martan3d/AirMiniTransmitter/pcb/BlueRidgeEngineering/completed.png

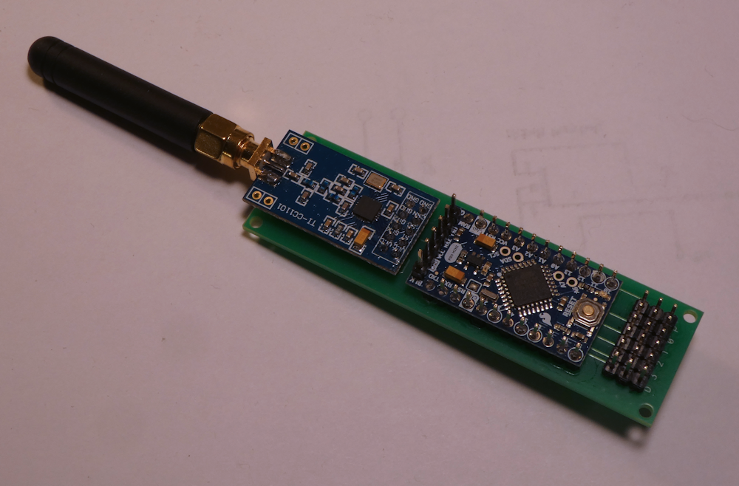
pcb/BlueRidgeEngineering/completed.png
