martan3d/AirMiniTransmitter/doc/Including_Timer_Latency_Effects.pdf

## Including Latency Effects in Arduino ISR’s

See file ArduinoInterrupts.pdf (and probably here). (https://my.eng.utah.edu/~cs5789/handouts/ArduinoInterrupts.pdf)

This shows how the to-be-determined CNT(?) is determined.

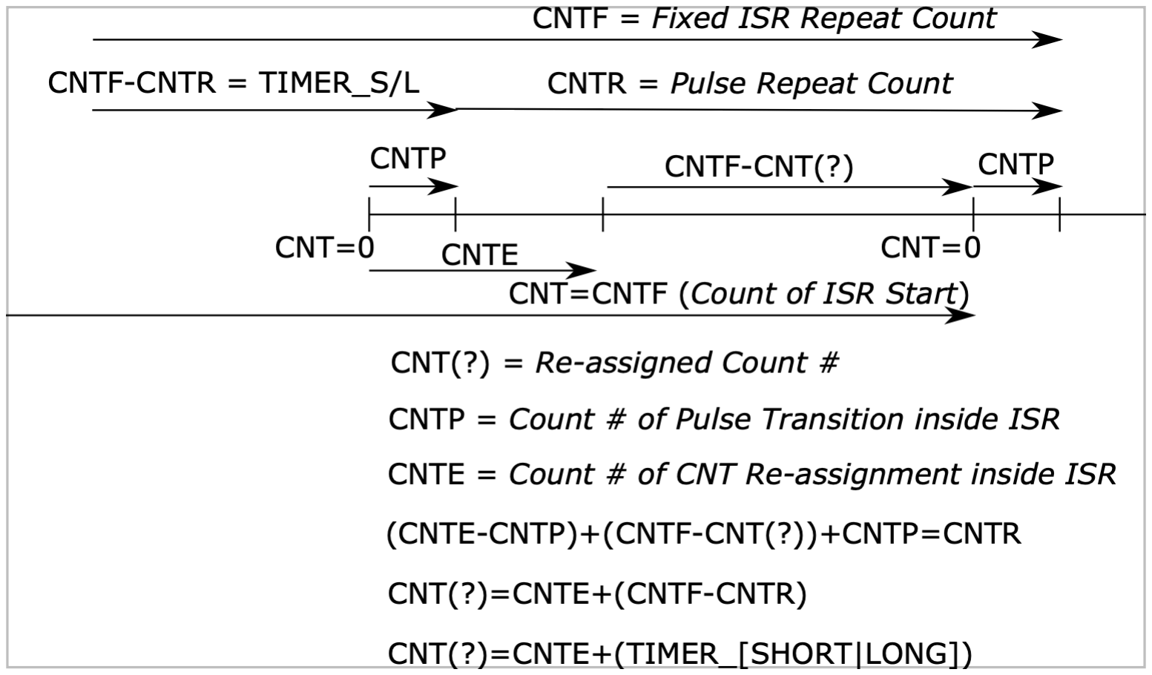
[picture p8: figure]

See https://www.avrfreaks.net/forum/tut-c-newbiesguide-avr-timers?
name=PNphpBB2&file=viewtopic&t=50106 (https://www.avrfreaks.net/forum/tut-c-newbies-guide-avr-timers?name=PNphpBB2&file=viewtopic&t=50106) for a decent interrupt tutorial
