martan3d/AirMiniTransmitter/pcb/BlueRidgeEngineering/bottomlayer.png

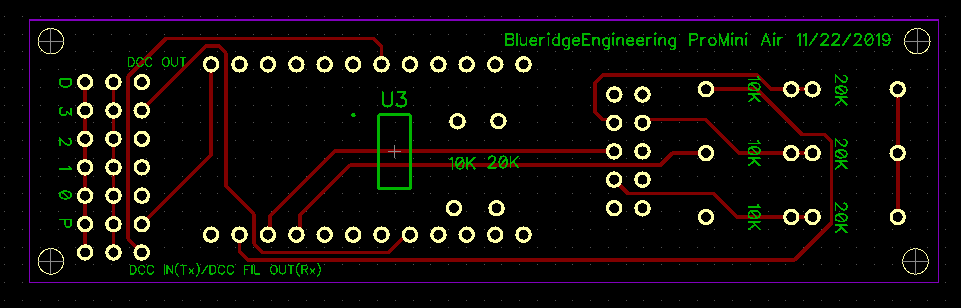
pcb/BlueRidgeEngineering/bottomlayer.png
