martan3d/AirMiniTransmitter/pcb/BlueRidgeEngineering/toplayer.png

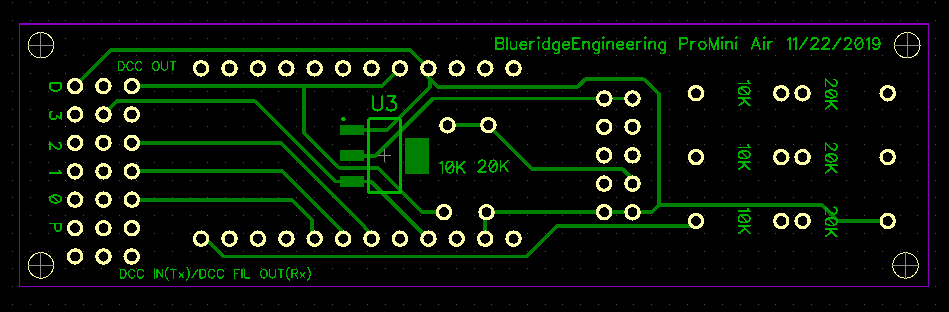
pcb/BlueRidgeEngineering/toplayer.png
