martan3d/AirMiniTransmitter/doc/ProMiniAir_Users_Manual.pdf

## User’s Manual for the ProMiniAir Transmitter and Receiver

OScaleDeadRail
https://oscaledeadrail.com

Darrell Lamm
darrelllamm0@gmail.com

January 29, 2025
Copyright© 2019-2024, Darrell Lamm. All rights reserved.

## Contents

1 Introduction | 4
2 About DCC | 4
3 Quick-Start | 4
3.1 Using Multiple Transmitters with Multiple PMA Receivers on Different
4 ProMiniAir Settings/Configuration | 15
5 Integration | 18
6 RF Receiver Compatibility | 24
A Firmware Installation | 41
B Regulatory Notices | 44
References | 46
Abbreviations/Acronyms | 46
Glossary | 46

## List of Figures

1 | Typical model railroad battery-powered radio-controlled application . . . . | 5
2 | The ProMiniAir transmitter using an external DCC throttle | | 6
3 | The components and connections needed for the ProMiniAir transmitter
| using an external DCC throttle | | 7
4 | Integrated ProMiniAir/WiFi-equipped EX-CommandStation transmitter . . | 7
5 | The components and connections needed for the “stand-alone” ProMiniAir
| transmitter | | 8
6 | Example of ProMiniAir receiver connections (w DRV8871) | | 9
7 | The components and connections needed for the ProMiniAir receiver (DRV8871
amplifier) | 10
8 | Example ProMiniAir receiver connections (w Cytron MD13S) | 11
9 | The components and connections needed for the ProMiniAir receiver (Cytron
amplifier) | 12
10 | LCD showing DCC message sent | 12
11 | LCD showing DCC message received | 13
12 | Receiver LCD display | 14
13 | The ProMiniAir antenna connector (U.FL) | 19
14 | ProMiniAir connections for AVR programmer | 19
15 | ProMiniAir receiver connections | 21
16 | ProMiniAir transmitter connections | 23
17 | ProMiniAir receiver integration with battery power, a Cytron H-bridge
“amp,” and antenna | 24
18 ProMiniAir receiver integration with battery power, a DRV8871 H-bridge
“amp,” and antenna | 25
19 | DCC data collected from a “typical” and Airwire throttle | 27
20 | Gwire U.FL connector | 28
21 | Tam Valley Depot DRS1, MKIII | 29
22 | The recently-released Tam Valley Depot DRS1, MkIV receiver | 29
23 | The recently-released Tam Valley Depot DRS1, MkIV receiver with U.FL
plug | 30
24 | The NCE D13DRJ wireless decoder | 31
25 | The S-Cab LXR-DCC receiver with a built-in antenna | 33
26 | Demonstration that the ProMiniAir transmitter successfully transmits to the
LXR-DCC receiver | 34
27 | ProMiniAir’s outputs with valid RF DCC signal | 38
28 | ProMiniAir’s insertion of last DCC packet when no valid RF DCC signal,
filtering off | 39
29 | Tam Valley Depot and Gwire outputs with no valid RF DCC signal | 39
30 | ProMiniAir’s outputs with no valid RF DCC signal, filtering on | 40
31 | GitHub Source download | 41

## List of Tables

1 | ProMiniAir Settings and Configuration | 17
2 | RF Receiver Summary | 26

## 1 Introduction

NOTE: Continuous hardware and software improvements will always outpace documentation updates.
Before understanding how to set up and use the ProMiniAir transmitter and receiver, let’s set the stage with Figure 1. What’s different from typical model railroads is that power comes from a battery rather than electrified rails, and DCC (more about this in a moment) control information is received by a radio receiver (from a radio transmitter connected to a DCC throttle) rather than from DCC signals imposed on the track voltage by a throttle. This battery-powered, radio-controlled method of operation is sometimes called “dead-rail” because neither power nor signal is applied to the rails.

## 2 About DCC

We’ll introduce some terminology that may be new. The National Model Railroad Association (NMRA) set forth a standard [1] for communicating with decoders onboard locomotives and other model railroad devices called Digital Command Control (DCC). DCC-compliant throttles control and configure these devices by sending coded, digital voltage waveforms over wires or tracks (usually) to these devices, which sift out those addressed to them. These coded waveforms contain digital messages or “packets” specify an action and an “Address” that determines the recipient device. Most DCC packets are addressed to a specific recipient, although a few kinds of messages are for all listening recipients.
Any DCC output (say from Digitrax, NCE, or other DCC throttle such as the lowcost WiFi-equipped EX-CommandStation (https://dcc-ex.com) we offer) can be wirelessly transmitted using the ProMiniAir transmitter over the “Airwire Channels” 0-16 in the North American 902– 928 MHz or European 868-870 MHz “ISM Band” band (the Airwire or European channel (channel 18) and output power level is adjustable as described below) to a variety of RF receivers, including the ProMiniAir receiver, that in turn, convert the RF transmissions back to DCC signals any DCC decoder can “understand.”
We also provide a North American channel 17 for Stanton-Cab transmitters (to the ProMiniAir receiver) or Stanton-Cab receivers (from the ProMiniAir transmitter).
After the ProMiniAir has been interfaced and powered as described in the next section, the ProMiniAir transmitter or receiver can be operated without further ado. However, you can reconfigure some aspects of the ProMiniAir’s operation as described later in this Manual.

## 3 Quick-Start

We provide the ProMiniAir transmitter or receiver as a fully-assembled, modular device, already connected to any additional modular components necessary to act as either a transmitter or receiver.

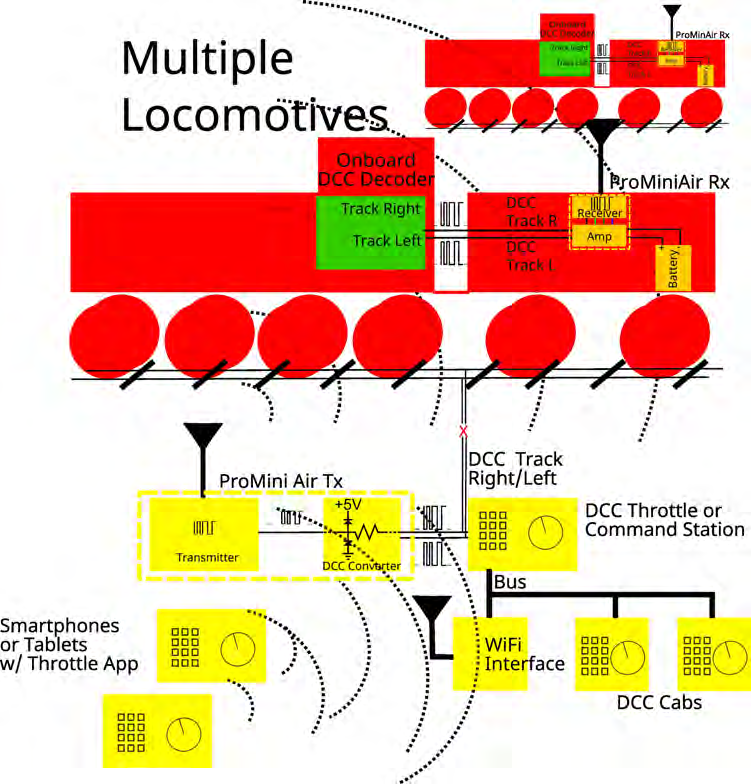
[picture p11: figure]

Figure 1: Typical model railroad battery-powered radio-controlled application. In some cases, such as the Airwire transmitters, the throttle and transmitter are combined. Also, the receiver and amplifier may be combined, such as for Airwire and Tam Valley Depot receivers. We provide the required DCC Converter for the ProMiniAir Tx or DCC Amplifier for the ProMiniAir Rx.

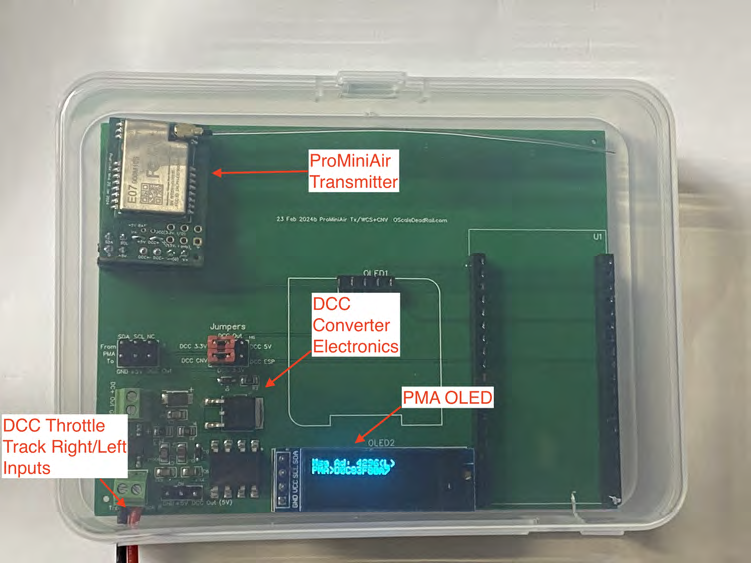
[picture p12: figure]

Figure 2: The ProMiniAir transmitter using an external DCC throttle. The components are now integrated on a PCB to eliminate wiring problems.

For the ProMiniAir transmitter, you simply connect the DCC Converter to a DCC throttle’s Track R/L output that is used as both a power and DCC data source (Figures 3 and 2), or simply plug in power to use the WiFi-equipped EX-CommandStation (https://dcc-ex.com) we offer as a fully standalone transmitter that allows you to use a smartphone’s WiThrottle-compatible app to connect to the ProMiniAir transmitter (Figures 4 and 5).
If you are using the integrated, “Standalone” PMA Tx/WiFi+EX-CommandStation, see these instructions. (https://oscaledeadrail.com/instructions-for-the-standalone-prominiair-transmitter/)
For the ProMiniAir receiver, connect battery power to the power harness plug and plug the DCC amplifier’s output to the Track R/L inputs to the DCC decoder (Figure 9 and 6). Both the ProMiniAir transmitter and receiver can be optionally connected to an Organic Light-Emitting Diode (OLED) display that uses the “I2C” interface that uses ProMiniAir outputs GND, VCC (+5V), SDA (3.3V data), and SCL (3.3V clock) as input. The display provides information on DCC messages received (PMA < DCC Packet) and sent (PMA > DCC Packet). See Figures 10 and 11. Note that some figures show an older Liquid Crystal Display (LCD) no longer used with ProMiniAir.

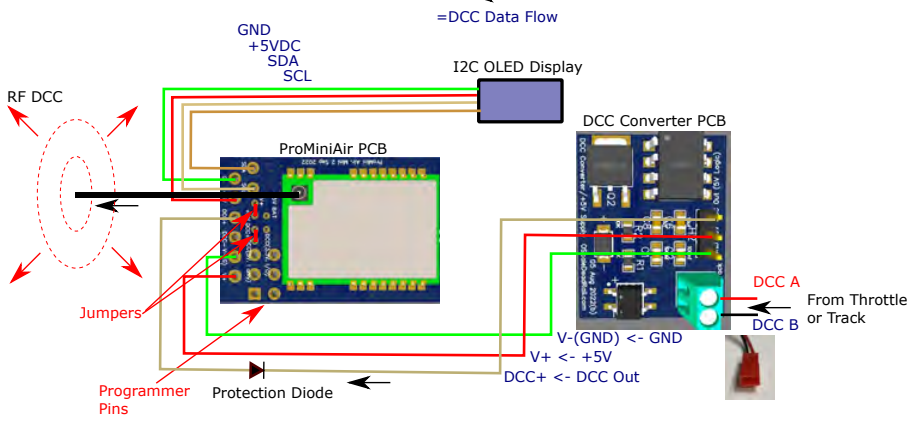
[picture p13: figure]
DCC B; DCC A; DCC Converter PCB; ProMiniAir PCB; From Throttle or Track; RF DCC; I2C OLED Display; =DCC Data Flow; DCC+ <- DCC Out; V-(GND) <- GND; GND +5VDC SDA SCL; Programmer; Protection Diode; Pins; Jumpers

Figure 3: The components and connections needed for the ProMiniAir transmitter using an external DCC throttle

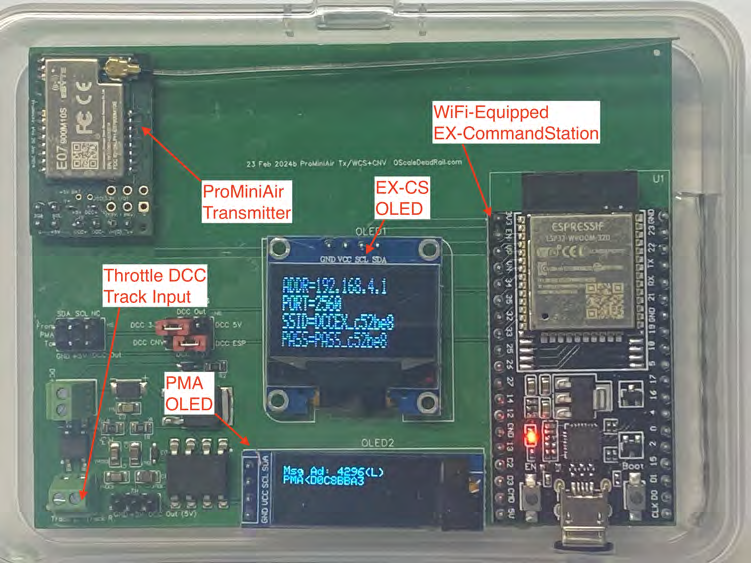
[picture p14: figure]

Figure 4: Integrated ProMiniAir/WiFi-equipped EX-CommandStation (https://dcc-ex.com) transmitter. The DCC converter is retained to provide optional external throttle DCC inputs to the EX-CommandStation. (https://dcc-ex.com) The ProMiniAir transmitter is then directly connected to the WiFi-equipped EX-CommandStation’s (https://dcc-ex.com) DCC outputs for a complete, stand-alone solution, allowing connections from both USB-connected and smartphone throttles, as well as allowing DCC inputs from an external throttle.

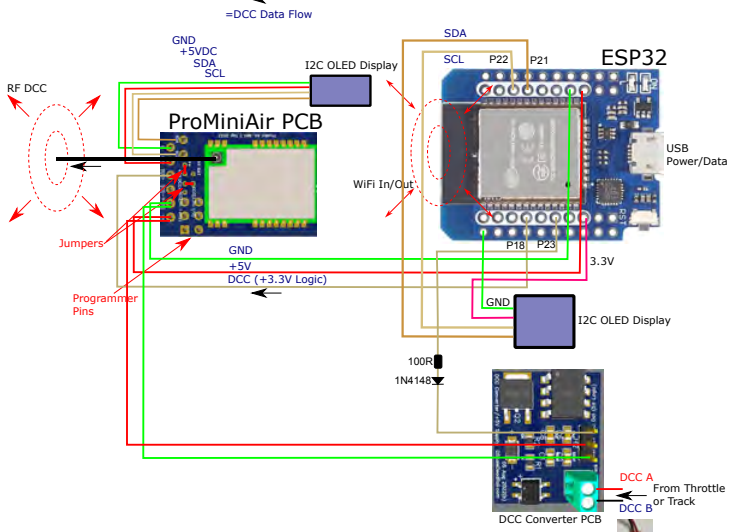
[picture p15: figure]
ESP32; ProMiniAir PCB; RF DCC; I2C OLED Display; =DCC Data Flow; DCC (+3.3V Logic); GND; GND +5VDC SDA SCL; WiFi In/Out; SDA; SCL; USB Power/Data; DCC B; DCC A From Throttle or Track; DCC Converter PCB; Programmer Pins; Jumpers

Figure 5: The components and connections needed for the “stand-alone” ProMiniAir transmitter with optional DCC throttle input.

Of course the OLED display cannot be used once the ProMiniAir receiver is mounted, but we strongly suggest that you keep the OLED display connected to the ProMiniAir transmitter so you can monitor the ProMiniAir transmitter’s state such as broadcast channel and power, and DCC message content.

### 3.1 Using Multiple Transmitters with Multiple PMA Receivers on Different Channels

Only on startup, the ProMiniAir Receiver will “listen” on its Default Channel, and if it doesn’t find a valid signal, it will start scanning on Channels in the following order: 0(A), 18(E), 17(S), 1(A), 2(A), 3(A), 4(A), 5(A), 6(A), 7(A), 8(A), 9(A), 10(A), 11(A), 12(A), 13(A), 14(A), 15(A), and 16(A); where A=Airwire, E=EU, and S=Stanton Cab. This feature allows an easy technique for using multiple compatible transmitters (ProMiniAirtransmitters, such as Airwire transmitters, etc.) that transmit on different Channels using the following technique:

1. Ensure all transmitters and receivers are OFF.
2. Turn ON Transmitter #1 on Channel C#1 (C#1 = 0, 1, ..., 18)
3. Turn ON only the ProMiniAir Receivers you want to auto-scan and “lock” on Channel C#1. It is useful to test the locos to ensure the onboard ProMiniAir Receiver has properly locked on Channel C#1.
4. Turn OFF Transmitter #1. Leave the receivers ON! The ProMiniAir Receivers will stay locked on Channel #1, patiently waiting for a valid signal on this Channel!

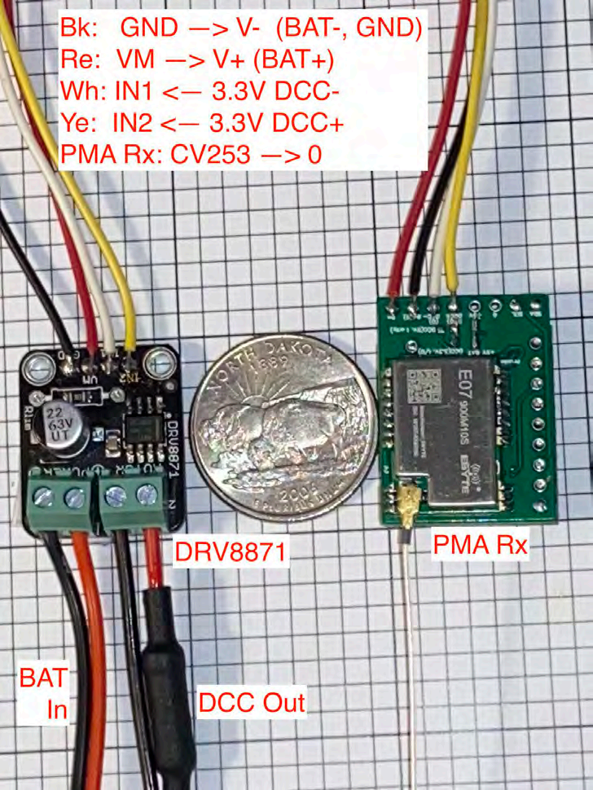
[picture p16: figure]

Figure 6: Example ProMiniAir receiver connections with a DRV8871 amplifier. Note the 1-ohm current-limiting resistor on the DCC out.

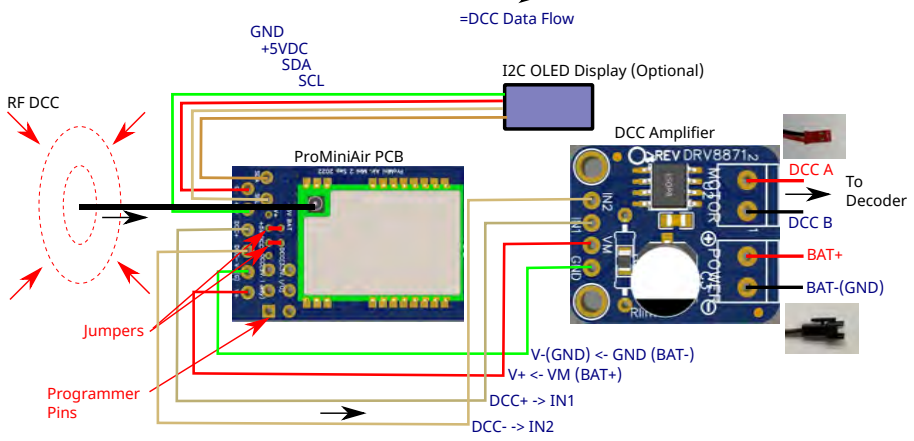
[picture p17: figure]
DCC B; DCC A; DCC Amplifier; ProMiniAir PCB; To Decoder; RF DCC; I2C OLED Display (Optional); =DCC Data Flow; DCC+ -> IN1; V+ <- VM (BAT+); V-(GND) <- GND (BAT-); GND +5VDC SDA SCL; DCC- -> IN2; BAT+; BAT-(GND); Programmer Pins; Jumpers

Figure 7: The components and connections needed for the ProMiniAir receiver for an H-bridge “amplifier” that uses opposite-polarity inputs.

5. Turn ON Transmitter #2 on Channel C#2 (please make sure C#2 is NOT the same as C#1).
6. Turn ON the next set of ProMiniAir Receivers that you want to auto-scan and “lock” on Channel C#2. Again, it’s useful to test the locos operating on this Channel.
7. Turn OFF Transmitter #2. At this point, no transmitters should be ON, but two groups of ProMiniAir Receivers locked locked on to Channel C#1 or C#2 remain ON.
8. Continue to Steps 5–7 for all additional Transmitters and groups ProMiniAir Receivers.
9. At this point in time all Transmitters should be OFF with all ProMiniAir Receives patiently waiting in groups locked onto Channels C#1, C#2, etc.
10. Now turn ON all of the Transmitters! Each group of ProMiniAir Receivers will now receive valid signals on the Channel it locked onto at startup!

In addition to the DCC message info provided in Figures 10 and 11, the ProMiniAir receiver’s OLED display also provides either the incoming DCC message’s address or the ProMiniAir own address, the channel number it’s receiving on, and the filtering status. See Figure 12.
Newer versions of the ProMiniAir use more compact and power-conserving OLED (128x32) displays. The information conveyed on OLEDs is the same as that on LCDs. Of course, once the ProMiniAir receiver is mounted, we cannot use the OLED (LCD) display. Still, we strongly suggest that you keep the OLED (LCD) display connected to the

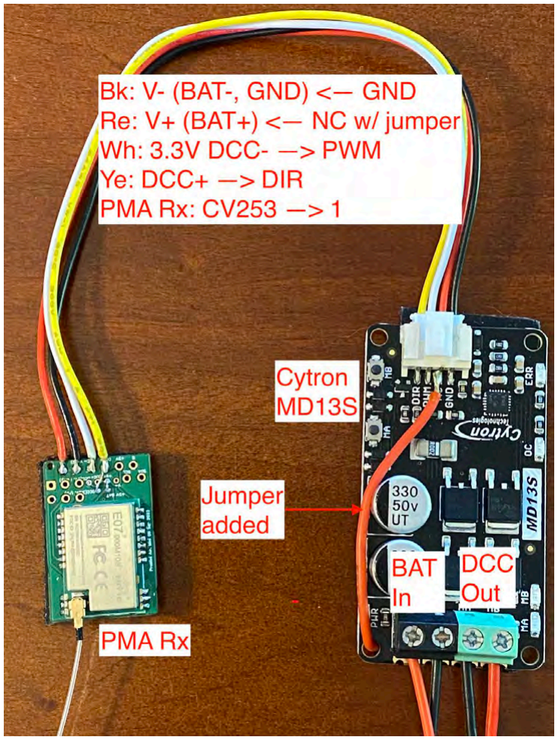
[picture p18: figure]

Figure 8: Example ProMiniAir receiver connections with a Cytron MD13S “amp”

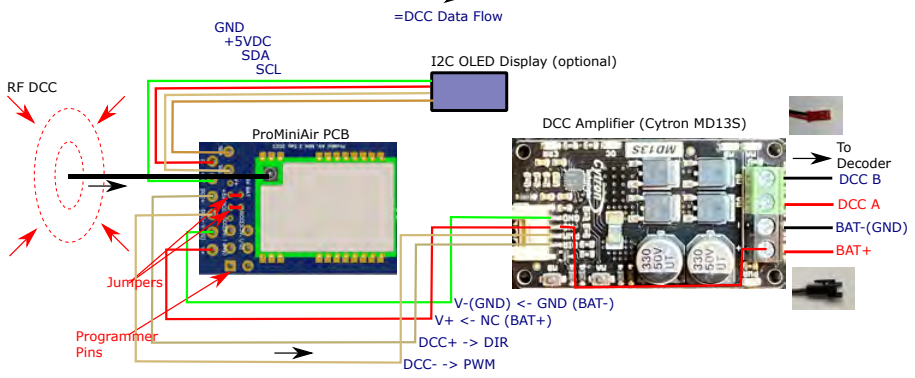
[picture p19: figure]
DCC B; DCC A; To Decoder; RF DCC; I2C OLED Display (optional); =DCC Data Flow; DCC+ -> DIR; V+ <- NC (BAT+); V-(GND) <- GND (BAT-); GND +5VDC SDA SCL; DCC- -> PWM; BAT+; BAT-(GND); Programmer Pins; Jumpers

DCC Amplifier (Cytron MD13S) ProMiniAir PCB

Figure 9: The components and connections needed for the ProMiniAir receiver (Cytron amplifier) that uses “locked anti-phase” inputs.

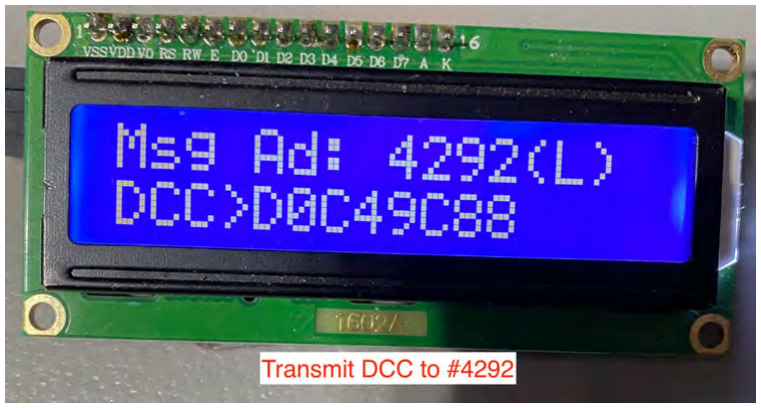
[picture p20: figure]

Figure 10: LCD showing message DCC sent (Tx: sent wirelessly; Rx: sent to DCC amplifier)

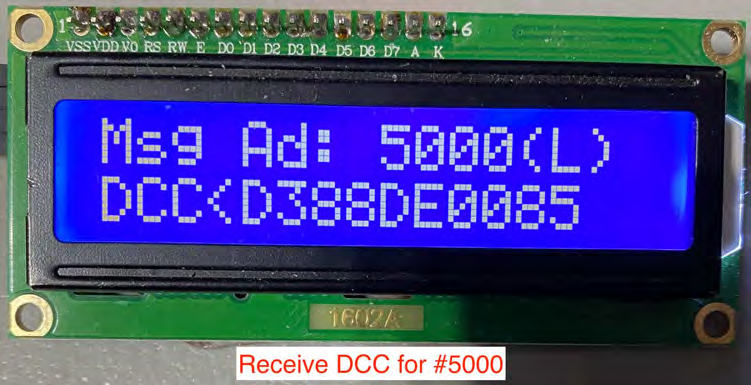
[picture p21: figure]

Figure 11: LCD showing message DCC received (Tx: received from DCC throttle; Rx: received wirelessly)

ProMiniAir transmitter so that you can monitor changes in the ProMiniAir transmitter’s settings, such as broadcast channel and power.

### 3.2 Additional Technical Information

The ProMiniAir requires interfacing with additional electronics that we provide. For the transmitter, the DCC signals that would normally be applied to the tracks by a DCC throttle are input to a simple “DCC Converter” that provides both 5V DC power and 5V logic DCC signal for the ProMiniAir transmitter. See Figure 3 and 2.
The “stand-alone” ProMiniAir transmitter does NOT require, but can use, an external DCC throttle and is its own DCC command station with WiFi and USB that allow external apps to run on a smartphone or PC to send throttle commands to the onboard DCC command station. See Figures 5 and 4 for the connections between the EPS32 hosting the command station software and the ProMiniAir transmitter.
Newer versions of the ProMiniAir transmitter use 3.3V logic DCC as input. In this case, a “protection” switching diode (1N4148), pointing “against” the input, is supplied that connects between the +5V DCC source and the 3.3V DCC input to the ProMiniAir transmitter. Technically, the ProMiniAir activates the internal “pull-up” resistor of the DCC+ input allows the diode to limit input voltages properly. Any ProMiniAir provided to you will have the proper interfacing between the DCC Converter and the ProMiniAir

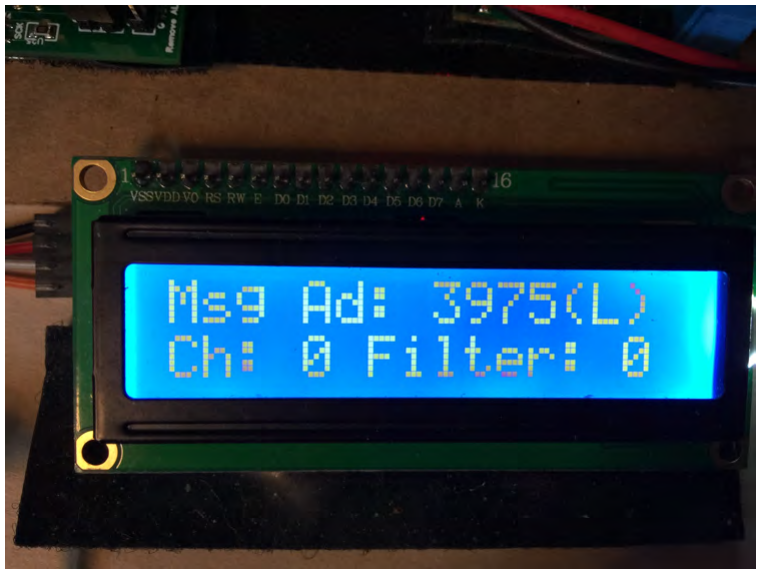
[picture p22: figure]

Figure 12: Receiver LCD showing message or self-address, channel number, and filtering status

receiver.
For the ProMiniAir receiver, the 5V (or 3.3V for newer versions) logic DCC signal outputs DCC+/DCC- from the ProMiniAir receiver is converted by a “DCC amplifier” back to “track DCC” signals that an onboard DCC decoder can “understand.” See Figures 9, 7 6, 8 for examples of connections of the ProMiniAir receiver with H-bridges that use either “locked anti-phase” inputs (DCC+ → 3.3V DCC, DCC- → +3.3V DC) or opposite polarity inputs (DCC+ → “positive 3.3V DCC”, DCC- → “opposite-polarity 3.3V DCC”).
We decided to take this modular approach to allow the following:
1. separation of the transceiver from other electronics that might cause RF interference,
2. the user to replace failed components (and not the entire assembly), and
3. us to reduce our exposure to supply chain disruptions and parts obsolescence, keeping costs low.

We believe this “modular” approach gives you installation and parts replacement flexibility. An additional benefit of the ProMiniAir’s modularity is that we can repurpose a transmitter as a receiver or vice versa with a simple firmware change.

### 3.3 Antennas for the ProMiniAir

The ProMiniAir transmitter comes with a “whip” antenna that preserves FCC/IC/ETSI/CE approval for the ProMiniAir transmitter containing the Anaren A110LR09x or A1101R09x, or the Ebyte E07-900M10S transceiver daughterboards. The approval numbers are the following:
- FCC ID: X7J-A1107 (Anaren), 2ALPH-E07900M10S (Ebyte)
- IC: 8975A-A11072401

The OScaleDeadRail site (https://oscaledeadrail.com/information-on-the-promini-air-receiver-and-transmitter/) discusses antennas that may be used with the ProMiniAir receiver in cases where the provided whip antenna is not feasible to use. We do not recommend you replace the approved antenna for the ProMiniAir transmitter because it may violate the FCC/IC/ETSI/CE approvals for an “active transmitter.”

## 4 ProMiniAir Settings/Configuration

Note: The instructions here refer to both the ProMiniAir transmitter (Tx) and receiver (Rx). Where necessary, we will try to differentiate between these options with “Tx” or “Rx” for the ProMiniAir transmitter or receiver, respectively.
The ProMiniAir has many default configuration settings that should make it useful “out of the box,” and “OPS Mode” (sometimes called “Programming on the Main” or “PoM”) re-configuration by the DCC throttle described below can change these settings, perhaps the most important of which is the Airwire Radio Frequency (RF) channel to transmit/receive on. But first, we need to explain how to make the ProMiniAir “listen” to the DCC throttle’s re-configuration commands explicitly meant for the ProMiniAir.
While DCC throttles are mostly concerned with commanding the speed, direction, and other behavior of locomotives, they can be used to reconfigure the “decoders” that are busy interpreting the DCC commands sent by the DCC throttle. Usually, reconfiguration involves changing lighting effects and other behavior of devices on a locomotive at a specific address, and “OPS mode” is very convenient for doing so. Each DCC throttle manufacturer has a slightly different method for putting the throttle into “OPS mode” so that it can communicate with a decoder at a specific address, but once in this mode, the DCC throttles all send the same NMRA-compliant, DCC packets to reconfigure the recipient decoder by means of changing the value of a Configuration Variable (CV).
This last point is the source of a lot of confusion. A Configuration Variable (CV) is the fixed address number with a set purpose where we will deliver a change in its value held at this address. We usually refer to the fixed address with a set purpose as “CV#”, where # is some number. For instance, CV1 holds the value of a device’s “short address” (whose value can be between 1 and 127). The value stored at this address can be changed, so we often refer to the value held at the CV address # as “CV#=value.”
The ProMiniAir “listens” to electrical signal DCC commands from the throttle (Tx) or from a wireless DCC signal (Rx), and if the address of a command matches the ProMini-Air’s address, which is 9900(Tx)/9901(Rx) by default (CV17=230, CV18=172(Tx)/173(Rx)), while the throttle is in “OPS mode”, the ProMiniAir can be re-configured. Note: Previous versions of ProMiniAir had default long addresses of 9000(Tx)/9001(Rx) (CV17=227, CV18=40(Tx)/41(Rx))!
Table 1 provides CVs that can be changed to re-configure the ProMiniAir. To change these values, the throttle that the ProMiniAir connects (Tx) or RF DCC signal listens (Rx)

to must first select the current address of the ProMiniAir, which is 9900(Tx)/9901(Rx) by default. Then according to the instructions for the particular throttle, set the throttle in “OPS mode” or “programming-on-the-main” of Configuration Variables (CVs).
Table 1 also provides valid values for the CVs, so if the user attempts to set an invalid value for a CV, the entry will be ignored and will NOT take effect! All changes to CV values made in “OPS mode” are persistent after power-down except for CV254 (RF power level), which will reset to the original default value of 8 upon power-up. This setting does not critically affect the ProMiniAir receiver (Rx). This feature prevents the ProMiniAir transmitter from producing unexpected high-power RF output upon turn-on.
In general, changing the ProMiniAir’s address should not be necessary. But, if the user needs to change the address, the following information will help. It’s a little complicated. If the user is not changing from a short to a long address or vice versa, no change in CV29 is needed. The fifth bit of CV29 specifies whether to use a “long” (bit 5=1) or “short” (bit 5=0) address. For the ProMiniAir, no other bits of CV29 are relevant, so either set CV29=0 to use the “short” address specified in CV1 or set CV29=32 to use the “long” address specified by CV17 and CV18.
When resetting the “long address” for the ProMiniAir, the user must set CV17 before setting CV18! Once the user programs the value of CV18, the ProMiniAir’s address will change to the new address, whose value we set by the funny formula:

Address = (CV17value − 192) ∗ 256 + CV18value,

so, for the default values for CV17 and CV18 in Table 1: (231-192)*256 + 15/14(Tx/Rx) = 9900(Tx)/9901(Rx). Changing the address by first setting CV17 and then CV18 means that the ProMiniAir will no longer accept “OPS mode” changes at the old address, and the user must change the throttle’s address to the new address before going back into “OPS mode” for any further configuration changes to the ProMiniAir. Similarly, if the user changes the value of CV29, then the address for the ProMiniAir may have changed from long-to-short or short-to-long address, so the user must change the address on the throttle to communicate with the ProMiniAir in “OPS mode” at the new address.
It may become necessary to reset the ProMiniAir completely. An example is when power “glitches” corrupt the EEPROM memory during start-up when the ProMiniAir is writing to EEPROM. The user can force a “factory” reset where you return the ProMiniAir to its original settings by setting the throttle or wireless transmitter into “OPS” mode, selecting the ProMiniAir’s DCC address, and setting CV8 to 8. The ProMiniAir will ignore other values for CV8. If successfully executed, the ProMiniAir will display a reset message if an OLED is connected. Regardless, do not turn off the power during reset, which may last several seconds. Turning off power during reset almost guarantees EEPROM corruption, requiring yet another “factory” reset, so please wait at least ten seconds before turning off the ProMiniAir following a factory reset.
Some final points about the reconfiguration of the ProMiniAir:
- While many DCC throttles have alternative methods for re-configuring decoders, such as “Service Mode” and “Quick Decoder Setup”, the only method that the Pro-MiniAir will respond to is the very simple “OPS Mode” or “programming-on-themain mode” (POM) that allows specific CVs to be directly set.

Table 1: ProMiniAir Settings and Configuration

Feature | CV # | Valid CV Vals | Default | Comments
RF Channel | CV255 | 0–16, 17, 18 | 0 | Airwire Ch. 0-16, S-Cab Ch. 17, EU Ch. 18
RF Power | CV254 | 0–10 | 8 | Experimentation is required
Locked Anti-phase On/Off | CV253 | 0 or , 0 | 1 | DCC+/DCC- output type (Rx)
DC Level | CV248 | 0 or , 0 | 1 | DCC A level when no valid DCC and DCC filtering on
DCC filtering | CV246 | 0 or , 0 | 0 | DCC filtering OFF (= 0) or ON (, 0) (Rx)
Channel wait period | CV245 | 0–60 | 1 | Channel waiting period in sec (Rx)
Repeat last valid DCC packet | CV244 | 0 or , 0 | 1 | Repeat last valid DCC packet (, 0) or insert preamble bits (= 0) while wait-ing for a valid DCC packet
Transceiver DEVIATN code* | CV243 | 0-255 | 80 | The transceiver’s GFSK “DEVIATN” value (NOT persistent!)
Number of preamble bits* | CV242 | 0-255 | 30 | Tx only! A value < 16 uses received preamble bits and >= 30 activates Airwire cutout
Timer long counts* | CV241 | ≥ 67 | 27 | (256-CV241)*0.5uS = DCC 1/2 “zero” duration
Timer short counts* | CV240 | 0–255 | 141 | (256-CV240)*0.5uS = DCC 1/2 “one” duration
Transceiver FREQ2 code** | CV235 | 0-255 | NA | The transceiver’s “FREQ2” value (NOT persistent!)
Transceiver FREQ1 code** | CV234 | 0-255 | NA | The transceiver’s “FREQ1” value (NOT persistent!)
Transceiver FREQ0 code** | CV233 | 0-255 | NA | The transceiver’s “FREQ0” value (NOT persistent!)
Configuration | CV29 | 0–255 | 32 | CV29=32 to use long address
Long addr low byte | CV18 | 0–255 | 14(Tx), 15(Rx) | Default CV17 & CV18 make Address = 9900(Tx)/9901(Rx)
Long addr high byte | CV17 | 192– 231 | 231 | Program CV17 before CV18!
Factory reset | CV8 | 8 | NA | CV8=8 causes “factory” reset
Short addr | CV1 | 1–127 | 3 | CV29=0 to use short address
*Resets to default on power-up
**CV243(DEVIATN), CV233(FREQ0), CV234(FREQ1) must be set before CV235(FREQ2) to initiate reset

- Technically the ProMiniAir is not a “multi-function” decoder, but we have chosen the addressing and reconfiguration of the ProMiniAir as if it were one because the user usually becomes quite adept at quickly:
1. changing the decoder address to the ProMiniAir’s,
2. putting the throttle in “OPS mode”,
3. making CV changes to re-configure the ProMiniAir,
4. exiting “OPS mode”, and finally
5. changing the DCC throttle address back to whatever locomotive the user is trying to control.

## 5 Integration

To complete the integration of the ProMiniAir receiver (Rx) or transmitter (Tx), you must establish some external connections.

### 5.1 Overview of Connections

See Figures 9 and 7 for an overview of the connections to and from the ProMiniAir for the receiver and 3 and 5 for the transmitter. THERE IS NO PROTECTION AGAINST IN-CORRECT BATTERY OR EXTERNAL POWER CONNECTIONS!!! You will destroy the ProMiniAir immediately if you reverse the GROUND and POSITIVE POWER SUP-PLY connection!
The Anaren and Ebyte transceiver daughterboards have a versatile U.FL plug for antenna connections. You can plug in either the U.FL “whip” antenna we provide or a U.FLto-SMA or U.FL-to-RP-SMA cable that screws into a remotely-mounted antenna. “Patch” antennas (e.g., Molex 211140) are also available with a U.FL connector. See Figure 13 for details on these connections.
The ProMiniAir has several connections that provide the following:
- AVR “ISP” programmer connections (Figure 14), Section A provides details on how to re-program the ProMiniAir using the AVR “ISP” programmer.
- I2C display connections (GND, +V, SDA, SCL).
- Input power (+5V to +30V and GND).
- 5V (or 3.3V for newer versions) logic DCC inputs (Tx, see 5.3) or outputs(Rx, see 5.2).

Which power and data connections you use depends on whether the ProMiniAir will act as a receiver (Rx) or a transmitter (Tx). THERE IS NO PROTECTION AGAINST IN-CORRECT BATTERY OR EXTERNAL POWER CONNECTIONS!!! You will destroy

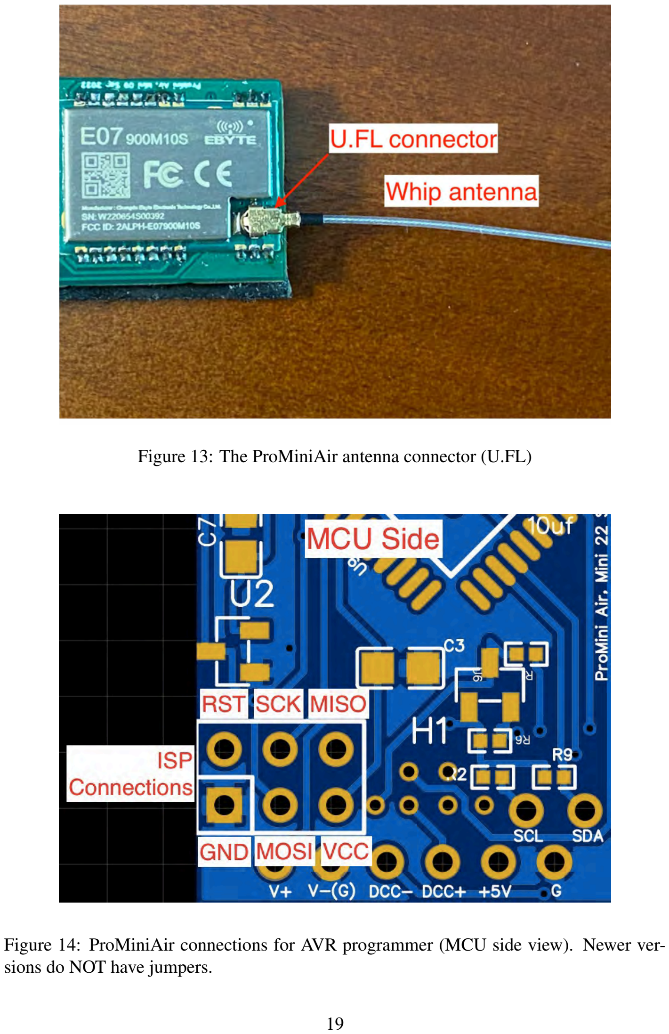
[picture p23: page 20]

Figure 13: The ProMiniAir antenna connector (U.FL)

Figure 14: ProMiniAir connections for AVR programmer (MCU side view). Newer versions do NOT have jumpers.

the ProMiniAir immediately if you reverse the GROUND and POSITIVE POWER SUP-PLY connection!
We will break down these connections for the ProMiniAir receiver and transmitter in the following two sections.

### 5.2 ProMiniAir Receiver Connections

See Figure 15 for the ProMiniAir receiver’s typical power and data connections we use when integrating the ProMiniAir with an amplifier. V+ and V-(GND) are received from the amplifier, which also uses battery power, and the DCC+ and DCC- outputs return to the amplifier. Note that the “+5V” jumper is connected to “+5V BAT” to provide +5VDC to a OLED display from an onboard voltage regulator that converts V+/V- to +5V/GND.
It is possible to use a separate +5VDC/GND voltage source connected to V+ and V-, and in this case the “+5V” jumper is connected to “+V” instead of “+5V BAT” to provide +5VDC/GND output to any connected OLED display as well as powering the onboard electronics.
Newer versions of the ProMiniAir do NOT have jumpers; simply use +5V to +30V DC input that is converted to +3.3V onboard for the MCU (the “brains”) and transceiver (the “radio”). See Figure 15.
The ProMiniAir receiver must connect to an external DCC “amplifier”¹
that converts
the 5V (3.3V for newer versions) logic DCC from the ProMiniAir receiver to DCC Track Right/Track Left (sometimes called DCC “A/B”) that a DCC decoder requires. This DCC amplifier uses battery power, and the inputs from the ProMiniAir receiver to provide the power and DCC messages, coded as a bipolar DCC waveform, to the decoder for both power and DCC messages.
These “DCC amplifiers” are usually medium to large amperage H-bridge circuits that accept pulse width modulation (PWM) input to provide precision output control for electric motors. The maximum PWM frequency of these amplifiers is usually high enough (20kHz or greater) to reproduce DCC signals accurately. See Figure 15.
Depending on the particulars of your installation, the author will provide an appropriate DCC amplifier as part of your ProMiniAir Rx purchase.
We generally provide one of two “DCC amplifiers” with the ProMiniAir recever:
- The excellent Cytron MD13S high-power (13A continuous) DCC amplifier may be purchased here (https://smile.amazon.com/gp/product/B07CW3GRL6/ref=ppx_yo_dt_b_search_asin_title?ie=UTF8&amp;psc=1) It uses “locked-antiphase” modulation requiring the ProMiniAir to output 3.3V logic-level DCC on DCC+ and a “high” 3.3V output on DCC-. This output scheme is activated by setting CV253 to 1, the default.
- The AdaFruit DRV8871 (https://www.adafruit.com/product/3190) or DRV8871 clones (https://smile.amazon.com/dp/B07W5Z5W8C?psc=1&ref=ppx_yo2ov_dt_b_product_details) are a smaller (1.0”x0.8”x0.4”) 3.6A amplifier requiring two 3.3V logic-level DCC inputs that are inverted with respect to each other. This output scheme is activated by setting CV253 to 0. On power-up, some decoders produce large “in-rush” currents because their large “keep-alive” capacitors are in near short-circuit condition before they charge. These in-rush currents

1Technically, it’s an H-bridge, but the term “amp” is convenient since we use low-voltage inputs to generate higher-voltage outputs.

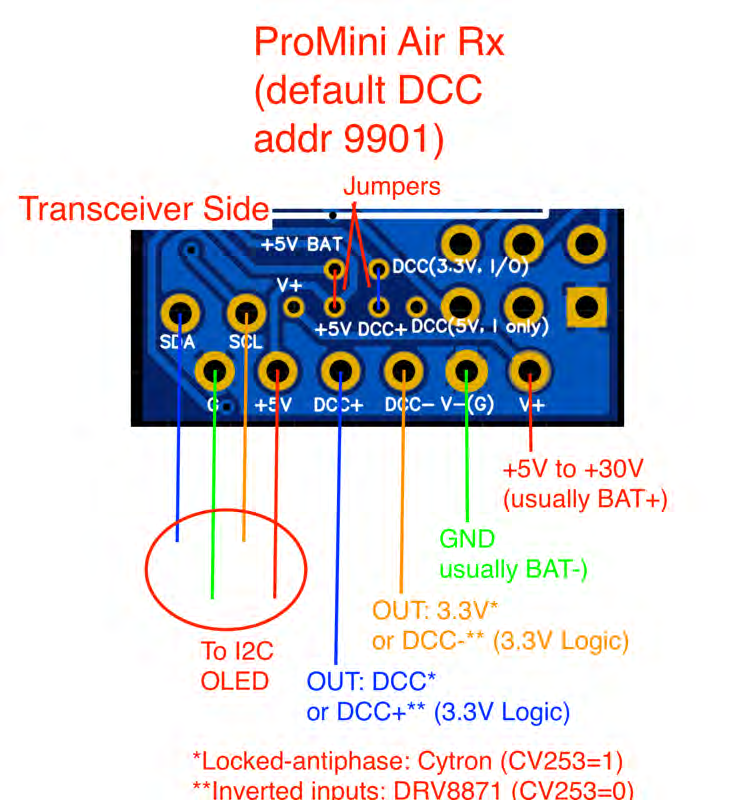
[picture p24: figure]

Figure 15: ProMiniAir receiver connections (transceiver side view). Newer versions do NOT have jumpers.

will cause the DRV8871 to shut down unless the output current is limited. We insert a 1 ohm resistor in series with the DCC output to limit the current during short-circuit conditions.

- You can successfully use more expensive high-amperage amplifiers (about $30 US as of 2020) found at Pololu here (https://www.pololu.com/product/2991) or here. (https://www.pololu.com/product/2992) These amplifiers are smaller (0.8” x 1.3”) than the Cytron.

Should you ever fully reset the ProMiniAir receiver (by setting CV8 to a value of “8” in PoM mode at the ProMiniAir’s DCC address), you will need to set the value of CV253 at the ProMiniAir’s DCC address (9901 by default) in PoM mode back to the proper value (which is “1” by default).

### 5.3 ProMiniAirTransmitter Connections

The ProMiniAir transmitter requires three inputs:

1. Ground, which is common to both power and logic outputs.
2. +V, which is DC power ranging from +5V to +30V.
3. Logic level DCC, designated DCC+, on the ProMiniAir PCB. Older versions of the ProMiniAir transmitter used +5V logic levels, and newer versions +3.3V. This logic-level DCC signal is produced by a DCC “converter” we supply that accepts tracklevel DCC and converts it to +5V and GND for power and +5V logic level DCC which is directly input to “DCC+” in older versions of the ProMiniAir or separated by a “protection” diode pointing “against” the DCC input that limits DCC inputs to the MCU (the ProMiniAir’s “brains”) to 3.3V. Alternatively, in the “stand-alone” version of the ProMiniAir transmitter, the 3.3V logic level DCC input comes (“DCC+”) from the EX-CommandStation’s motor driver DCC output. See Figures 3, 5 and 16.

The ProMiniAir transmitter provides I2C SDA (Serial DAta) and SCL (Serial CLock) outputs for an optional OLED display. GND and 3.3V are also provided should they be needed to power the display.

### 5.4 Integration of the ProMiniAir Receiver into a Locomotive

Of course, the real purpose of the ProMiniAir receiver and DCC amplifier is to integrate them into a locomotive for wireless DCC control using an onboard battery as power. For most installations, all that is necessary is to connect battery power to the DCC amplifier (which in turn supplies power to the ProMiniAir receiver) and the amplifier’s DCC output to the on-board DCC decoder.
We generally provide one of two “DCC amplifiers” (really H-bridge motor drivers) with the ProMiniAir recever:

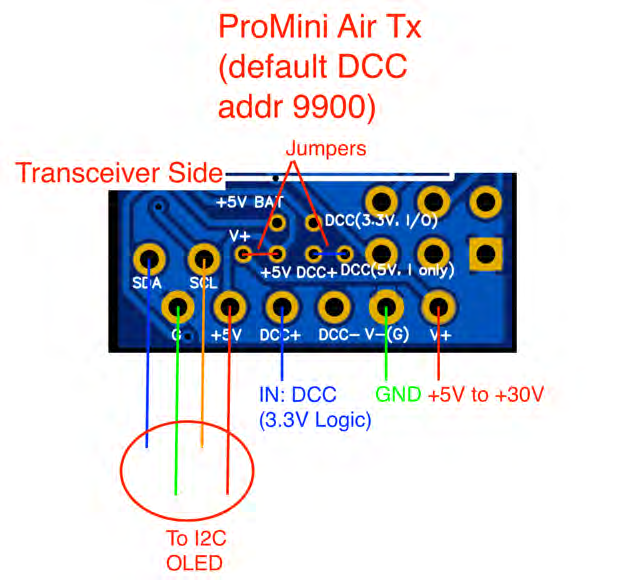
[picture p25: figure]

Figure 16: ProMiniAir transmitter connections (transceiver side view). Newer versions do NOT have jumpers.

- The excellent Cytron MD13S high-power (13A continuous) H-bridge motor driver may be purchased here, (https://smile.amazon.com/gp/product/B07CW3GRL6/ref=ppx_yo_dt_b_search_asin_title?ie=UTF8&amp;psc=1) as shown in Figure 17. It uses “locked-antiphase” modulation requiring the ProMiniAir to output logic-level DCC on DCC+ and a “high” output on DCC-. We activate this output scheme by setting CV253 to 1, the default.
- The AdaFruit DRV8871 (https://www.adafruit.com/product/3190) or DRV8871 clones (https://smile.amazon.com/dp/B07W5Z5W8C?psc=1&ref=ppx_yo2ov_dt_b_product_details) are smaller (1.0”x0.8”x0.4”) 3.6A H-bridge motor drivers requiring two logic-level DCC inputs that are inverted with respect to each other. We activate this output scheme by setting CV253 to 0. On power-up, some decoders produce large “in-rush” currents because their large “keep-alive” capacitors are in near short-circuit condition before they charge. These in-rush currents will cause the DRV8871 to shut down unless the output current is limited. We insert a 1-ohm resistor in series with the DCC output to limit the current during short-circuit conditions. See Figure 18.
- You can successfully use more expensive high-amperage amplifiers (about $30 US as of 2020) found at Pololu here (https://www.pololu.com/product/2991) or here. (https://www.pololu.com/product/2992) These H-bridge motor drivers are smaller (0.8” x 1.3”) than the Cytron.

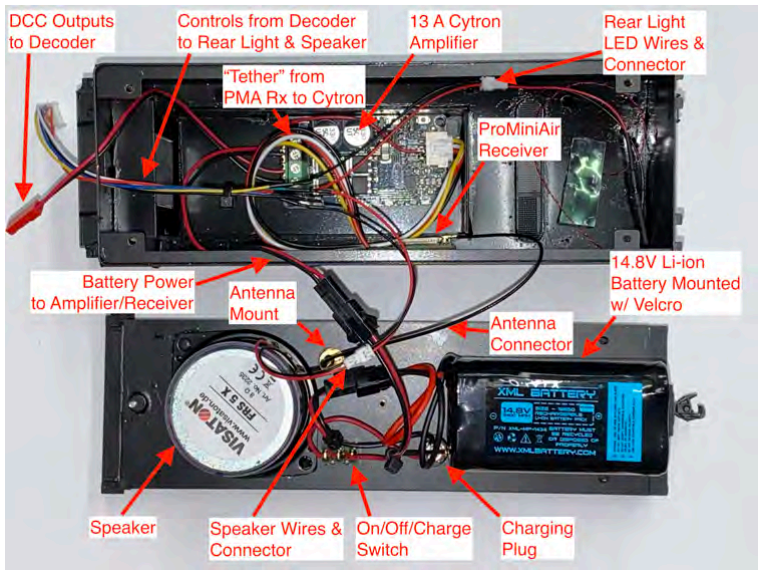
[picture p26: figure]

Figure 17: ProMiniAir receiver integration with battery power, a Cytron H-bridge “amp,” and antenna

## 6 RF Receiver Compatibility

We have successfully tested the ProMiniAir transmitter with several wireless, RF receivers, operating in the 902–928 MHz Industrial, Scientific, and Medical (ISM) band that are designed to interface with onboard DCC decoders:

- Airwire CONVRTR series
- QSI Solutions Gwire
- Tam Valley Depot DRS1, MkIII and MkIV
- Stanton Cab (S-Cab) receivers such as the LXR-DCC
- NCE D13DRJ wireless DCC decoder
- OScaleDeadRail ProMiniAir receiver.

We have also verified that the ProMiniAir transmitter works in the European ISM band at 869.85MHz with the Tam Valley Depot DRS1, Mk IV, receiver. This is Channel 18 on the ProMiniAir transmitter (and receiver).

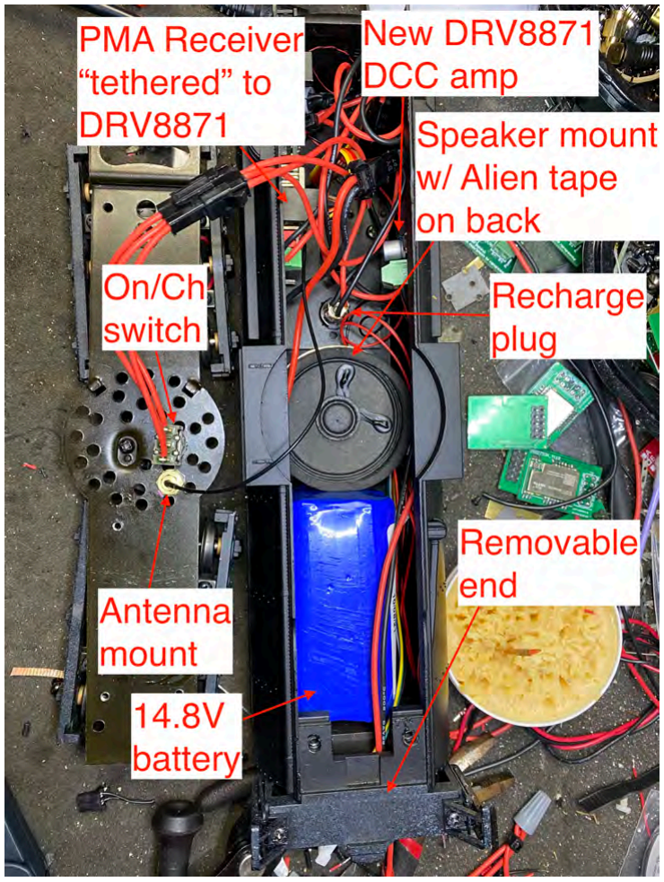
[picture p27: figure]

Figure 18: ProMiniAir receiver integration with battery power, a DRV8871 H-bridge “amp,” and antenna

### 6.1 Airwire CONVRTR Series

The company CVP (http://www.cvpusa.com/airwire_system.php) manufactures and supports its Airwire series of products that include hand-held wireless DCC-compliant throttles (such as the T5000 and T1300) and receivers, such as the CONVRTR series that seamlessly connects to DCC decoders onboard the locomotive. As a general comment, CVP provides excellent, detailed installation and operation documentation, and that is, in part, why they are dominant in some segments of wireless model railroad control. The CONVRTR receiver has some sophisticated features, such as setting its Airwire RF channel purely in software, as described in its User Guide. (http://www.cvpusa.com/doc_center/r0_B&W_CONVRTR-60_web.pdf) However, the CONVRTR interacts with the Airwire wireless throttles in ways that make it challenging to transmit “garden variety” DCC wirelessly to the CONVRTR for proper operation. The Airwire wireless throttles send a non-dcc “cutout” (1/2 “one” and 1/2 ”zero”) after the end packet bit from the previous DCC packet followed by numerous (30) DCC preamble bits by as a “keep-alive” signal for the CONVRTR. A red LED on the CON-VRTR board indicates received signal quality and flickers least when receiving numerous DCC preamble bits with the leading “cutout.” The brightness of the LED is an indication of received RF power. Typical DCC throttles are not designed with these concerns in mind and do not output enough DCC preamble bits or the leading “cutout” before the preamble to keep the CONVRTR “happy.” See Figure 19 for the unusual features of a Airwire throttle’s transmitted DCC.
To combat this problem, the ProMiniAir transmitter software intercepts “garden variety” DCC from the throttle and by default inserts 30 DCC preamble bits with a leading “cutout” to maintain communication with the CONVRTR.
This behavior can be modified by changing the default value of CV242 (=30) using OPS mode at DCC address 9900. Values of CV242 < 16 will cause the transmitter to use the input DCC packet’s number of preamble pulses. Values of CV242 >= 16 causes the transmitter to use CV242 preamble bits. Values of CV242 >= 30 will also cause the trasmitter to insert a “cutout” before the preamble. Setting CV242 >= 30 helps ensure Airwire compatibility.
You can turn on repeating the last valid packet while waiting for a new valid DCC packet with CV244 , 0 or insert preamble bits = 0 while waiting.
We caution the user that “Service Mode” commands will be sent wirelessly to all “lis-

Table 2: RF Receiver Summary
Name | Channels Antenna | RF Loss Output | CV27 Relevant?
CONVRTR | 0-16 | Int or U.FL | DC | Yes
Gwire | 0-7 | Wire or U.FL | Pulses | No
DRS1, MkIII | 16, 17 | Wire | Pulses | No
DRS1, MkIV | 0-17, 18 | Int or U.FL | Pulses | No
S-Cab LXR-DCC 17*, 11* | Int | DC | Yes
NCE D13DRJ | 16, 17 | Int | Pulses | No
ProMiniAir | 0-17,18 | SMA or U.FL DCC Preamble/DC* No/Yes**
Int=Internal, *single channel, **software configurable

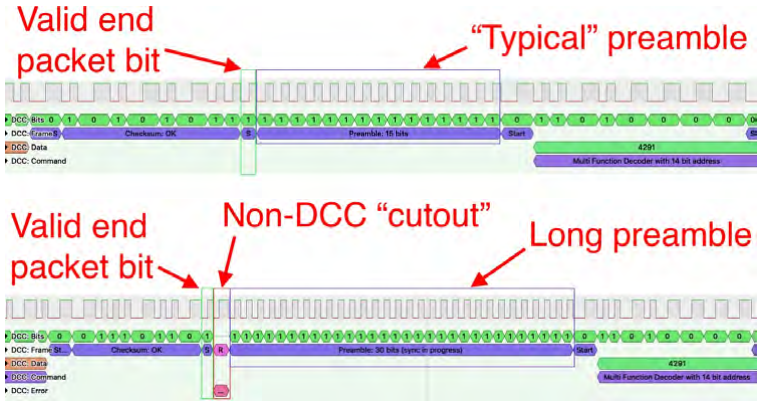
[picture p28: figure]

Figure 19: Data collected from a “typical” (top) and Airwire throttle (bottom) demonstrating the large number of preamble bits and leading “cutout” required to keep Airwire receivers “happy”

tening” wireless decoders because “Service Mode” does not use a specific DCC address! So, all wireless DCC receivers should be turned off except for the single “target” for “Service Mode” reprogramming. Note that most decoder reprogramming can be done in “OPS” mode, which will send reprogramming commands to a specific DCC address, so resorting to “Service Mode” should be a last resort.
Like the Gwire receiver below, the Airwire CONVRTR has a U.FL connector for connecting a shielded antenna cable from the receiver to an externally-mounted antenna. An internal antenna option is available as well for CONVRTR mountings that are not surrounded by metal.

### 6.2 QSI Solutions Gwire

The Gwire receiver operates on Airwire RF channels 0-7, which you must select from a dial on the device itself, and is a suitable wireless DCC receiver for the ProMiniAir. A nice feature of this receiver is an onboard U.FL connector (see Figure 20) that allows the user to connect a shielded antenna cable between the receiver and an externally mounted antenna. The U.FL connector is useful when we mount the antenna on the exterior of a metal locomotive or tender shell. See Blueridge Engineering’s website here (http://blueridgeengineering.net/index.php/wiki/gwire-to-5a-dcc-modifications/) and here (http://blueridgeengineering.net/index.php/wiki/cheap-airwire-dead-rail-dcc/) for details on how to interface the Gwire to any onboard DCC decoder. The Gwire presents no difficulties for the ProMiniAir transmitter, and you can find it on eBay at reasonably low prices.

### 6.3 Tam Valley Depot DRS1, MkIII

The DRS1, MkIII receiver operaates at 916.49 MHz, which is close enough to Airwire channel 16 at 916.37MHz to successfully connect. It will also operate on the ProMiniAir’s

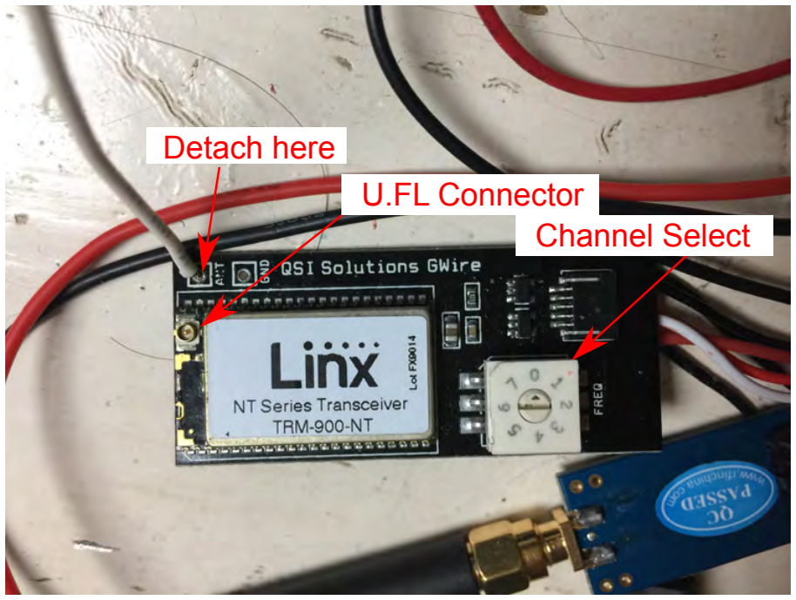
[picture p29: figure]
U.FL Connector; Detach here; Channel Select

Figure 20: Gwire U.FL connector. If using the U.FL connector, detach the wire antenna.

channel 17 at 916.48 MHz. This receiver has a long, single-wire antenna that provides efficient RF reception (see Figure 21). However, the user should place this wire outside any metal shell, which may be inconvenient in some mounting applications. The DRS1, MkIII, presents no difficulties for the ProMiniAir transmitter. The DRS1, MKIV, described in the next section, supersedes this receiver.

### 6.4 Tam Valley Depot DRS1, MkIV

The DRS1, MkIV, receiver completely departs from the DRS1, MkIII. It operates at the original Tam Valley 916.48 MHz frequency (S-Cab channel 17), Airwire Channels 0-16, and the European ISM band at 869.85MHz (channel “18”). The DRS1, MkIV, comes with either an internal antenna or a U.FL plug connecting to an external antenna. The DRS1, MkIV presents no difficulties for the ProMiniAir transmitter. This receiver is an interesting choice because it changes channels automatically until it finds sufficient RF signal carrying DCC packets. See Figures 22 and 23.

### 6.5 NCE D13DRJ Wireless Decoder

The NCE D13DRJ, (https://ncedcc.zendesk.com/hc/en-us/articles/201382375-D13SRJ-Retired) now, sadly, discontinued, is a dead-rail DCC decoder that originally touted compatibility with the Stanton Cab. (https://www.s-cab.com/radio-control.html) The decoder’s documentation is here. (https://ncedcc.zendesk.com/hc/en-us/article_attachments/200654955/D13drj.pdf) As shown

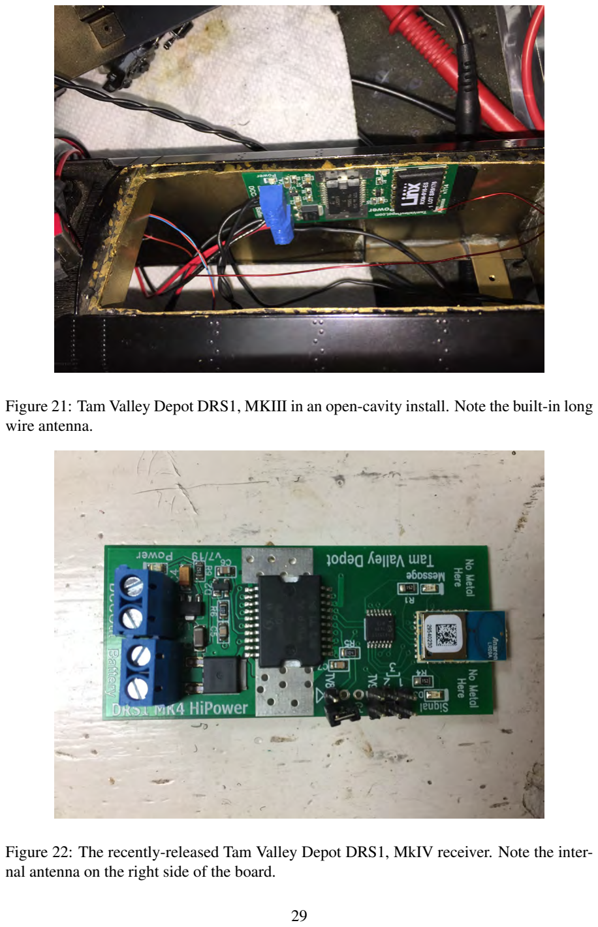
[picture p30: page 30]

Figure 21: Tam Valley Depot DRS1, MKIII in an open-cavity install. Note the built-in long wire antenna.

Figure 22: The recently-released Tam Valley Depot DRS1, MkIV receiver. Note the internal antenna on the right side of the board.

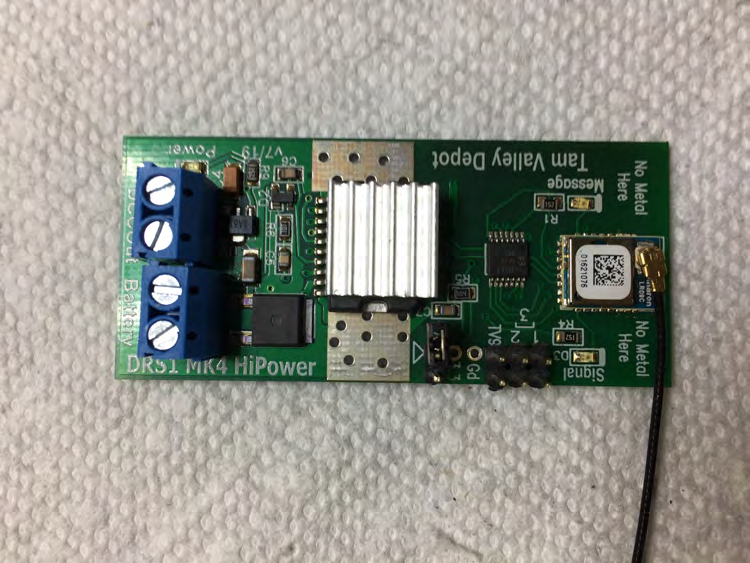
[picture p31: figure]

Figure 23: The recently-released Tam Valley Depot DRS1, MkIV receiver with a U.FL plug for connecting to an external antenna.

in Figure 24, the decoder is tightly integrated with the receiver.
The NCE D13DRJ uses the same receiver chip (the Linx RXM-916-ES (https://linxtechnologies.com/wp/product/es-series-rf-transmitter-receiver-modules/) operating at 916.48MHz) as the older Tam Valley Depot Mk III receiver. We have verified the NCE D13DJR works with the ProMiniAir transmitter on Airwire Channel 16 (916.37MHz) or Channel 17 (916.48MHz).

### 6.6 Stanton S-Cab Receivers

The Stanton Cab (or S-Cab) is a series of dead-rail transmitters and receivers developed and sold by dead-rail pioneer Neil Stanton, Ph.D. S-Cab products are available at this site (https://www.s-cab.com/) Stanton offers a hand-held transmitter, the S-Cab Throttle, (https://www.s-cab.com/radio-control.html) specifically designed to transmit to S-Cab RF receivers. These receivers include the S-CAB Radio Receiver (LXR-DCC) and Loco Receivers for HO, On3, On30, and some S-scale installations. Also, Stanton will provide an S-Cab receiver coupled with decoders for larger scales. The S-Cab website here (https://www.s-cab.com/radio-control.html) discusses the available options.
The S-Cab Throttle and receivers operate at 916.48MHz or 918.12MHz (single frequency only!). The former frequency is close to Airwire Channel 16 (916.36MHz), and the latter is the same frequency as Airwire Channel 11. However, Airwire hand-held transmitters WILL NOT WORK with S-Cab receivers on Channel 16, but will work on Channel 11. And Airwire receivers WILL NOT WORK with the S-Cab Throttle.

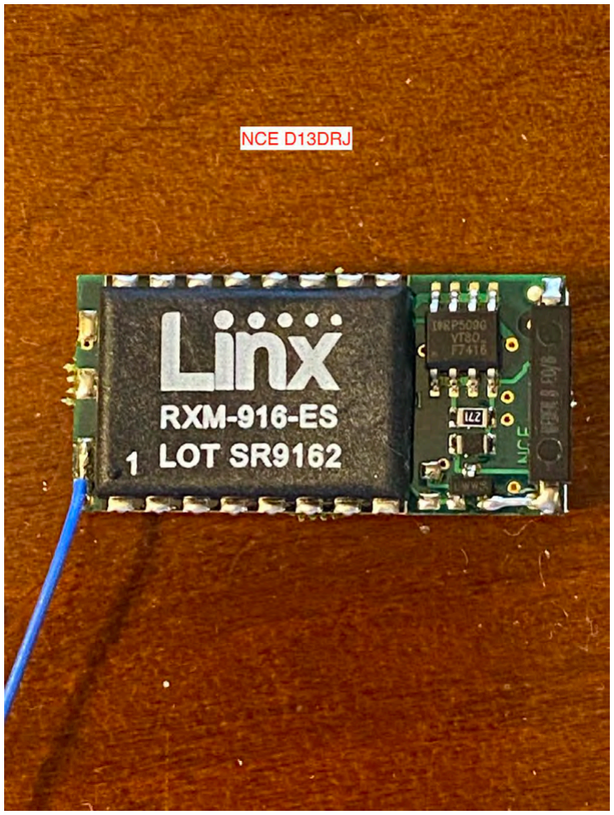
[picture p32: figure]

Figure 24: The NCE D13DRJ wireless decoder

We have devised the RF settings that allow the ProMiniAir transmitter (ProMiniAir Tx) to operate with the S-Cab receivers (such as the LXR-DCC, Figure 25), and we added these settings to an S-Cab compatible Channel 17 at 916.48MHz. This addition required moving the European Channel 17 to Channel 18. The ProMiniAir also works with S-Cab receivers on Channel 11 (918.12MHz). See Figure 26 for a demonstration of the ProMiniAir Tx transmitting to the S-Cab LXR-DCC receiver.

### 6.6.1 Operating the S-Cab Throttle with the ProMiniAir Rx

The specialized RF settings for Channel 17 also allow the S-Cab Throttle to transmit to the ProMiniAir receiver with just a tiny wrinkle to establish communication (more about this below).
Since the S-Cab Throttle transmits on Channel, the ProMiniAir Rx must use its automatic “channel search” capability to “find” the S-Cab Throttle’s intermittent transmissions on this Channel with it’s unique RF settings.
The S-Cab Throttle’s intermittent transmissions are where the “wrinkle” occurs. The ProMiniAir Rx’s channel search after power on quickly searches for transmissions in the following channel sequence: 0(A), 18(E), 17 (S-Cab), 1(A), 2(A), 3(A), ..., 16(A), where
(A) means Airwire channel, (E) means European ISM frequency 869.85MHz, and (S-Cab) means for S-Cab at 916.48MHz with other specialized settings.
The S-Cab Throttle’s transmissions are intermittent, so if the operator does nothing, the S-Cab Throttle might not be transmitting in the short time window when the ProMiniAir Rx is looking for transmissions on Channel 17. To force the S-Cab Throttle into nearly continuous transmissions, slide the speed control up and down continuously for several seconds while the ProMiniAir Rx is powering up to guarantee the ProMiniAir Rx has transmissions on Channel 17. If the ProMiniAir Rx does not “sync up” with the S-Cab Throttle, try again by turning the ProMiniAir Rx off and then back on while sliding the S-Cab’s speed control up and down.
We devised Channel 17 for S-Cab products operating at 916.48MHz. The ProMiniAir works with 918.12MHz S-Cab products on Airwire channel 11.

### 6.7 OScaleDeadRail ProMiniAir Receiver

The inexpensive ProMiniAir receiver presents no issues when used with the ProMiniAir transmitter. This receiver operates on Airwire RF channels 0–16, S-Cab channel 17, or the European ISM band at 869.85MHz (channel “18”) and requires a separate H-bridge “amplifier” to convert the ProMiniAir’s unipolar 3.3V DCC to bipolar DCC that provides sufficient power to the decoder. This receiver, and an appropriate H-bridge “amplifier” is available directly from the author or by searching on eBay with the string “ProMiniAir”.

### 6.8 Receiver and Decoder Behavior with Loss of RF

The designers of various DCC-compatible RF receivers have a several of strategies for what output to provide to the onboard DCC decoders when a valid RF signal is lost:

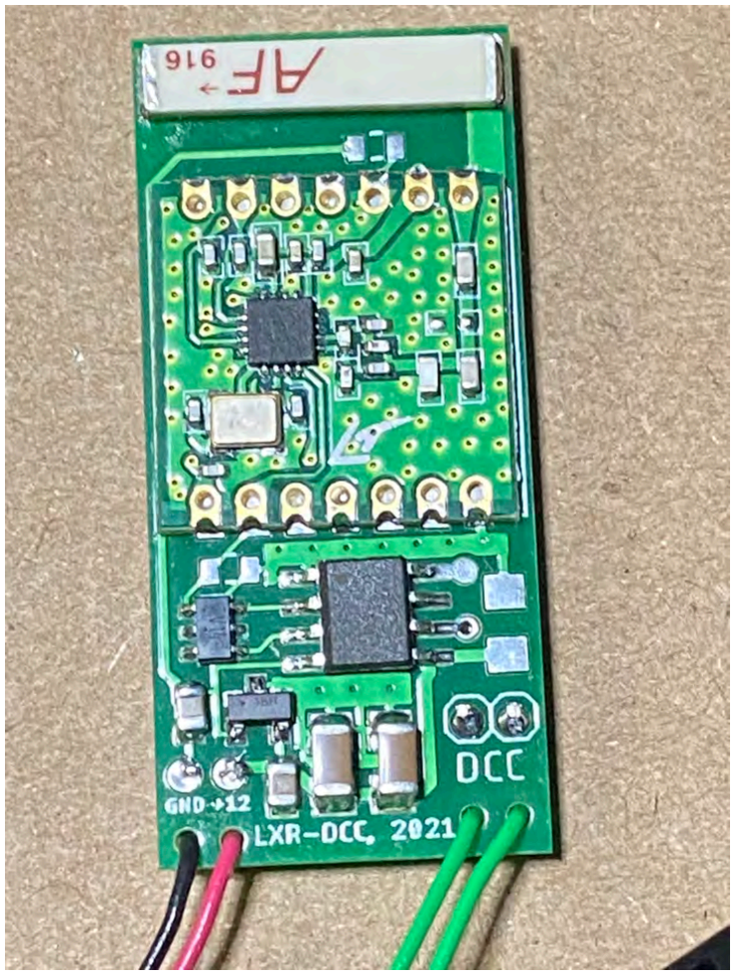
[picture p33: figure]

Figure 25: The S-Cab LXR-DCC receiver with a built-in antenna.

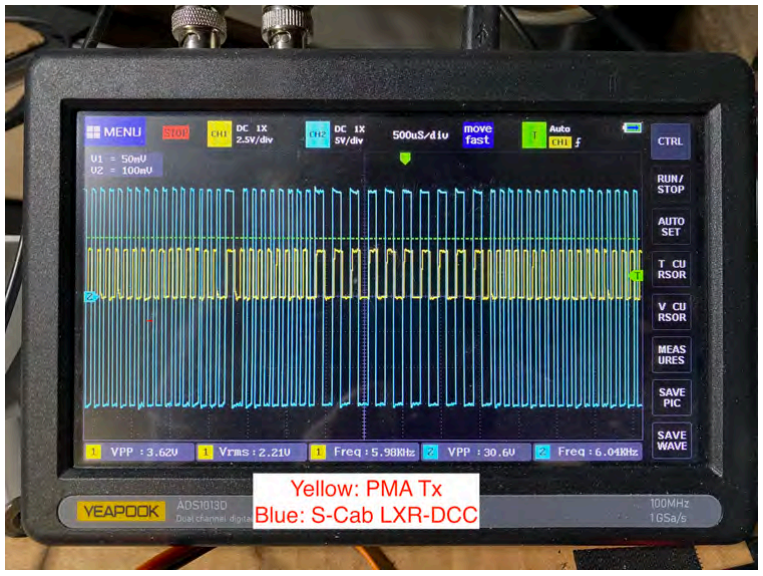
[picture p34: figure]

Figure 26: Demonstration that the ProMiniAir transmitter (yellow waveform) successfully transmits to the LXR-DCC receiver (blue waveform) on Channel 17. Note the very slight time delay of the LXR-DCC’s waveform.

1. Output the random pulses that the RF receiver naturally outputs when a valid RF signal is lost. This option will cause most DCC decoders to maintain direction and speed while the DCC decoder “sifts” the random pulses searching for valid DCC packets.
2. Output a fixed, positive Direct Current (DC) voltage to one of the DCC decoder’s “Track” inputs and a zero voltage DC the other “Track” input when either a) valid RF signal is lost or b) for some RF receivers such as the Airwire CONVRTR do not receive “keep-alive” DCC packets often enough from the RF transmitter. How the DCC decoder responds to these DC “Track” inputs depends upon DCC decoder configuration and, unfortunately, DCC decoder manufacturer discretion.
3. Output DCC “preamble” bits that keeps the decoder “happy” in its current operating state while it waits for the end of the DCC preamble.

Several NMRA-specified Configuration Variables (CVs) affect how decoders handle the loss of valid DCC packets, which is important to understand when using the ProMiniAir transmitter because the RF receivers may lose or receive corrupted RF signal from the ProMiniAir transmitter.
The NMRA standard S-9.2.4, (https://www.nmra.org/sites/default/files/s-9.2.4_2012_07.pdf) Section C “Occurrence of Error Conditions” [3] describes “Multi-Function Digital Decoder shall have a Packet Update time-out value.” Further down on line 60, the standard states, “A value of 0 disables the time-out (i.e., the user has chosen not to have a time-out)”. This part of the NMRA standard is not universally implemented by manufacturers, and it affects how decoders will respond to the loss of RF transmission of DCC packets. To implement this requirement, the NMRA standard NMRA standard S-9.2.2 (https://www.nmra.org/sites/default/files/standards/sandrp/pdf/s-9.2.2_decoder_cvs_2012.07.pdf) [2] has defined the “recommended”, but not “mandatory”, CV11, Packet Time-Out Value. A value of CV11=0 is defined to turn off the time-out, but CV11 is frequently not implemented.
However, another CV that is often implemented addresses some aspects of the loss of DCC. The “optional” CV27, Decoder Automatic Stopping Configuration is under reevaluation by NMRA, but the NMRA has taken no definite action for some time. Here is what the NMRA standard [2] currently (as of 2019) states about CV27:

Configuration Variable 27 Decoder Automatic Stopping Configuration
Used to configure which actions will cause the decoder to stop automatically.

Bit 0 = Enable/Disable Auto Stop in the presence of an asymmetrical DCC signal, which is more positive on the right rail.
“0” = Disabled “1” = Enabled

Bit 1 = Enable/Disable Auto Stop in the presence of an asymmetrical DCC signal, which is more positive on the left rail.
“0” = Disabled “1” = Enabled

Bit 2 = Enable/Disable Auto Stop in the presence of an Signal Controlled Influence cutout signal.
“0” = Disabled “1” = Enabled

Bit 3 = Reserved for Future Use.

Bit 4 = Enable/Disable Auto Stop in the presence of reverse polarity DC. “0” = Disabled “1” = Enabled

Bit 5 = Enable/Disable Auto Stop in the presence forward polarity DC. “0” = Disabled “1” = Enabled

Bits 6-7 = Reserved for future use.

Since DCC decoder manufacturers frequently do implement CV27, what electrical output the DCC-compatible RF receiver provides to the DCC decoder upon loss of a valid RF signal will influence how the DCC decoder responds. We will break this down for various brands of DCC-compatible RF receivers in the 902-928 MHz ISM band in the following subsections.
Note that some DCC decoders will not honor CV27=0; i.e., all auto-stopping features disabled. For example, with CV27 set to 0, the Zimo MX-696, (http://www.zimo.at/web2010/newsitems/MX696-2012-Februar_news_EN.htm) and probably other Zimo DCC decoders as well, will continue speed and forward direction if positive DC level is input to the “Right Track” DCC input, and a zero DC level is input to the “Left Track” DCC input. Under these “track voltage” conditions, the locomotive will stop if originally moving backward. Some (but not all) DCC-compatible RF receivers, such as the Airwire CONVRTR, provide these DC inputs if a valid RF signal is lost, but only if connected correctly.
The “correct” connection relates to how the user connects the DCC output from the RF receiver to the “Track Right” and “Track Left” inputs of the DCC decoder. Under normal circumstances, when there is a valid RF signal, which way the DCC decoder connects to the RF receiver does not matter. Under the exceptional case of DC-only output by the RF receiver, if it loses a valid RF signal, which way the DCC decoder connects to the RF transmitter does matter. The user will likely want the locomotive to continue forward with the loss of a valid RF signal, so some experimentation is required to determine which of the RF transmitter DCC outputs should connect to which of the DCC decoder’s “Track” inputs to achieve the desired behavior.
As a further complication, we recommend that the user turn off the decoder’s “analog” mode of operation by setting Bit 2 of CV29 to 0 to force the decoder to use “NMRA Digital Only” control of “Power Source Conversion” (see [2]). If Bit 2 of CV29 is set to 1, and again, we emphasize the user should probably not activate this feature, then “Power Source Conversion Enabled,” and then CV12 determines the power source; the most common of which is CV12=1, “Analog Power Conversion.”

### 6.8.1 Airwire CONVRTR Series

When the CONVRTR loses a valid RF signal or receives an insufficient number of DCC preamble bits, it detects these conditions and sends a fixed DC voltage to the decoder. Consequently, the user should set CV27 according to the description above.

While it seems that you would want the locomotive to stop if its RF receiver loses a valid RF signal, consider what might happen in tunnels or remote locations if a valid RF signal is lost. Stopping under these circumstances is probably not what the user wants, so we strongly suggest that the user set CV27=0.
We caution the user, however, that some DCC decoders, such as the new ESU Lok-Sound 5 L DCC, (http://www.esu.eu/en/products/loksound/loksound-5-l-loksound-5-l-dcc) do not honor the CV27=0 setting unless the decoder’s “Track Right/Left” is connected “correctly” to the CONVRTR’s “A/B” output. Experimentation may be required to determine the correct connection, but my experience is the following: CONVRTR A <–> Decoder Track Right & CONVRTR B <–> Decoder Track Left.

### 6.8.2 Stanton Cab LXR-DCC Receiver

If the S-Cab LXR-DCC loses valid RF reception, it will output a DC voltage. Depending on which of the LXR-DCC’s outputs are connected to which DCC track input to the decoder, this DC voltage will be considered as “positive” or “negative” DC voltage, and the decoder will respond depending on the decoder’s configuration. Consequently, like the CVP Airwire CONVRTR, the user should set CV27 according to the description above.

### 6.8.3 NCE D13DRJ

The NCE D13DJR wireless decoder integrates tightly with its Linx RXM-916-ES receiver. By default, the decoder will maintain direction, speed, and lighting outputs when it loses valid RF signals.

### 6.8.4 QSI Solutions Gwire and Tam Valley Depot DRS1 Series

The QSI Solutions (https://shedaker.wixsite.com/shedaker) Gwire (https://www.ebay.com/sch/i.html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) and Tam Valley Depot (https://www.tamvalleydepot.com) DRS1, MkIII and MkIV (http://deadrailinstalls.com/tam-valley-order-form/) DCC-compatible RF receivers will output random pulses to the onboard DCC decoder when a valid RF signal is lost, so setting CV27 is probably of no use. On the “plus” side, most DCC decoders will maintain locomotive direction and speed in the presence of these random pulses since the DCC decoder is actively sorting through these pulses for valid DCC packets, which is usually the behavior the user wants.
This Blueridge Engineering webpage (http://blueridgeengineering.net/index.php/wiki/gwire-to-5a-dcc-modifications/) describes how to modify the GWire for easy use as an RF receiver for any onboard DCC decoder.

### 6.8.5 OScaleDeadRail ProMiniAir Receiver

The OScaleDeadRail (https://oscaledeadrail.com) ProMiniAir receiver has a default long address of 9901. Like the ProMiniAir transmitter, the ProMiniAir’s receiver’s channel can be reset in “OPS Mode” by setting CV255 to a value in the range of 0–18. The ProMiniAir receiver has the following options when a valid RF signal is lost:

- Output DCC “preamble” bits that will keep the decoder “happy,” waiting for the end of the preamble. The decoder will continue to operate in its current state, including maintaining its current speed and direction.

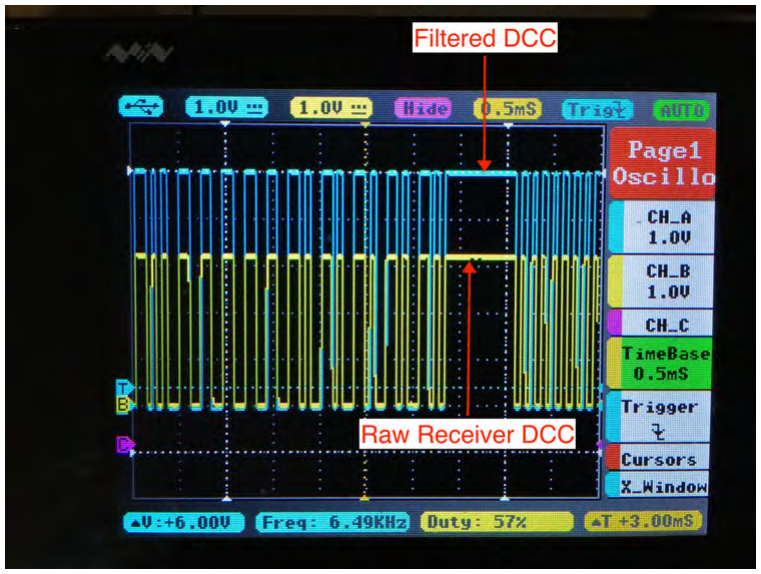
[picture p35: figure]

Figure 27: ProMiniAir’s raw transceiver and filtered DCC outputs with valid RF DCC signal

- Output either fixed positive or negative voltage DC to the onboard DCC decoder: In this case, setting CV27 for the onboard DCC decoder at its address is relevant. The user can set the ProMiniAir receiver to output fixed DC voltage when it loses a valid RF signal by setting CV246 to 1 in “OPS mode” at the ProMiniAir’s address. A positive DC voltage is output by setting the ProMiniAir receiver’s CV248 to 1 in “OPS mode” at the ProMiniAir’s address or a negative DC voltage is output by setting CV248 to 0. If the user does not want the locomotive to stop with the loss of a valid RF signal, then set CV27=0 for the onboard DCC decoder at its address. Of course, setting CV27 to other values (see above) in the DCC decoder will determine how the DCC decoder responds to the fixed DC voltage that the ProMiniAir outputs to the onboard DCC decoder upon loss of a valid RF signal. This setting is the default (CV246 > 0) for the ProMiniAir for compatibility with Airwire Receiver and is changed by setting CV246 to 0 to output preamble bits when RF reception is lost.

See Figures 27, 28, and 30 for how the ProMiniAir can be configured.

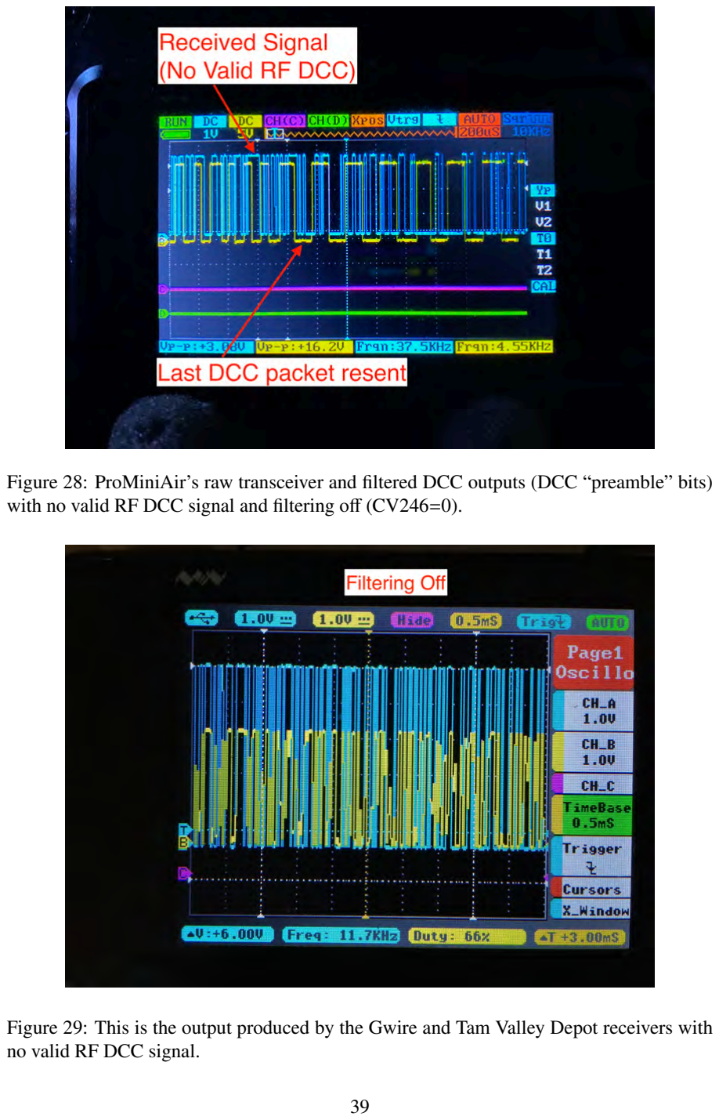
[picture p36: page 40]

Figure 28: ProMiniAir’s raw transceiver and filtered DCC outputs (DCC “preamble” bits) with no valid RF DCC signal and filtering off (CV246=0).

Figure 29: This is the output produced by the Gwire and Tam Valley Depot receivers with no valid RF DCC signal.

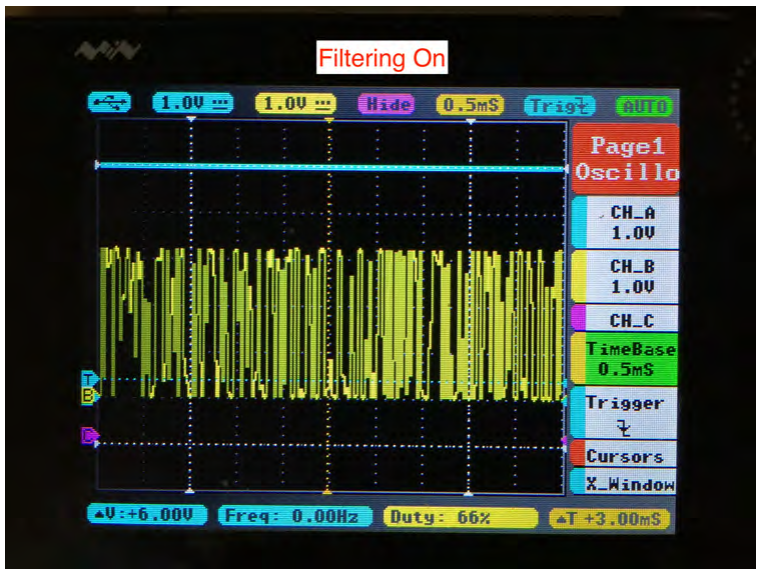
[picture p37: figure]

Figure 30: ProMiniAir’s raw transceiver and filtered DCC outputs with no valid RF DCC signal and filtering on (CV246=1, CV248=1). This is the output produced by the Airwire CONVRTR as well.

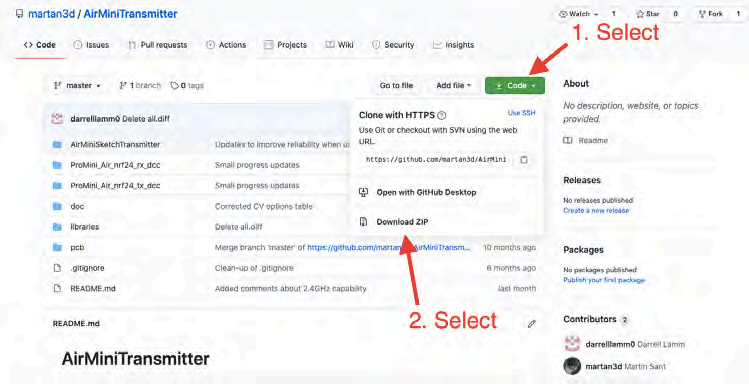
[picture p38: figure]

Figure 31: How to download the GitHub zip file that will maintain the directory structure

## A Firmware Installation

We provide the firmware already loaded in the ProMiniAir Tx and Rx. These instructions are for advanced users who want to update the firmware.
The source code is available from this GitHub site. (https://github.com/martan3d/AirMiniTransmitter) Locate the source code in a directory where the Arduino IDE can find it. You should retain the subdirectory structure to access the “project” with the Arduino IDE.
Depending on whether you want a transmitter or receiver, edit config.h (https://github.com/martan3d/AirMiniTransmitter/blob/master/libraries/config/config.h) to select the “define” for the transmitter or receiver.
For a receiver (Rx), config.h should look like this:

// #define EU_434MHz
/* For World-Wide 2.4GHz ISM band*/ // #define NAEU_2p4GHz

//////////////////////////////
// Set Transmitter or Receiver ////////////////////////////// /* Uncomment ONLY ONE #define*/ /* For receiver*/
#define RECEIVER

/* For transmitter*/
// #define TRANSMITTER

///////////////////////////////////////////////// // Set the default channel for NA/EU 900MHz only! /////////////////////////////////////////////////
#if defined(NAEU_900MHz)

/* Uncomment ONLY ONE #define*/
/* To set the default to NA channel 0 for 869/915MHz ISM bands only!*/ #define NA_DEFAULT
/* To set the default to EU channel 18 for 869/915MHz ISM bands only!*/ // #define EU_DEFAULT
#endif

////////////////////////////////////////// // Set the transceiver’s crystal frequency
//////////////////////////////////////////
/* Uncomment ONLY ONE #define*/
/* For 27MHz transceivers (e.g., Anaren 869/915MHz (CC110L) and Anaren 869MHz (CC1101) radios)*/
// #define TWENTY_SEVEN_MHZ
/* For 26MHz transceiver (almost all other radios, including Anaren 433MHz (CC1101), 915MHz (CC1101), and 2.4GHz (CC2500) radios)*/ #define TWENTY_SIX_MHZ
If you want a transmitter (Tx), then config.h should be the following:

// #define EU_434MHz
/* For World-Wide 2.4GHz ISM band*/ // #define NAEU_2p4GHz

//////////////////////////////
// Set Transmitter or Receiver ////////////////////////////// /* Uncomment ONLY ONE #define*/ /* For receiver*/
// #define RECEIVER
/* For transmitter*/
#define TRANSMITTER

///////////////////////////////////////////////// // Set the default channel for NA/EU 900MHz only! /////////////////////////////////////////////////
#if defined(NAEU_900MHz)

/* Uncomment ONLY ONE #define*/
/* To set the default to NA channel 0 for 869/915MHz ISM bands only!*/ #define NA_DEFAULT
/* To set the default to EU channel 18 for 869/915MHz ISM bands only!*/ // #define EU_DEFAULT
#endif

////////////////////////////////////////// // Set the transceiver’s crystal frequency
//////////////////////////////////////////
/* Uncomment ONLY ONE #define*/
/* For 27MHz transceivers (e.g., Anaren 869/915MHz (CC110L) and Anaren 869MHz (CC1101) radios)*/
// #define TWENTY_SEVEN_MHZ
/* For 26MHz transceiver (almost all other radios, including Anaren 433MHz (CC1101), 915MHz (CC1101), and 2.4GHz (CC2500) radios)*/ #define TWENTY_SIX_MHZ

Two further options are available. The first option selects the crystal frequency of the FCC/EC-approved transceiver: 27MHz (Anaren) or 26MHz (Ebyte). The second option specifies North American or European default use.
After you complete downloading the firmware into the Pro Mini, please do not remove the USB connection from the computer until the “secondary” LED, which indicates attempted communication over the SPI (serial peripheral interface) flashes on (it will not be bright). This step ensures you properly initialize the EEPROM!
You load the firmware into the Pro Mini MCU using an “AVR ISP,” such as the Sparkfun Pocket AVR Programmer or a less-expensive clone. This “ISP” downloading mode will bypass and erase the bootloader to directly load the firmware into the Pro Mini MCU. On boot-up with the bootloader now erased, the ProMiniAir’s MCU will almost instantly supply “3.3V logic DCC” to the DCC amplifier, which provides the DCC decoder with standard DCC waveforms. There is no “boot-up DC” and no need to set CV29, bit2=0. (I set it anyway.) With this solution, all DCC decoders I’ve tried (ESU, Zimo, MTH) startup without the “boot-up jerk.”
Physical connection between the ISP programmer and the ProMiniAir is established using the ISP holes shown below.
This “ISP” form of loading firmware is not as extensively used by folks using the Arduino IDE, but ISP loading is easily accessible within the Arduino IDE. The overly-brief method of ISP programming steps are the following:

1. Insert pins into the ISP’s 6-pin output plug. These pins will be inserted into conducting ISP holes in the ProMiniAir’s PCB in a later step.

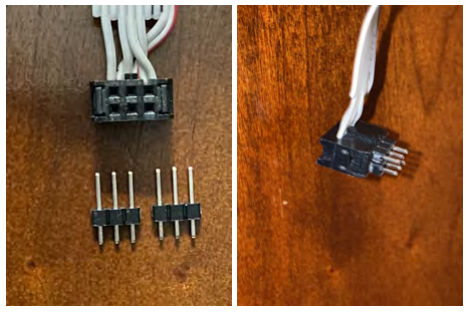
[picture p39: figure]

2. From the Arduino IDE, select the 16MHz Atmega328 MCU
3. From the Arduino IDE, Select Tools → Programmer → “USBtinyISP” (or whatever ISP programmer you are using).
4. Select the “AirMiniSketchTransmitter NMRA” sketch.
5. Connect the USBtinyISP (or other) Programmer (with power switch ON) to the computer using the USB connector.
6. Insert the ISP pins into the ProMiniAir’s ISP holes in alignment with the pin-out as shown.

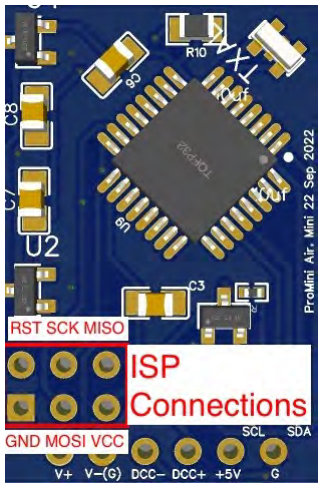
[picture p40: figure]

7. Tilt the inserted pins to make firm electrical contact with the sides of the conducting holes and hold them in this position. The plug should be inserted into the “MCU” side as shown.

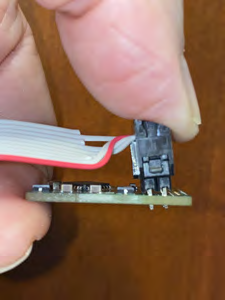
[picture p41: figure]

8. Select Sketch → Upload using a Programmer. The Arduino IDE will compile the sketch and download the resulting firmware to the Pro Mini via the USBtinyISP, bypassing (and erasing) the bootloader.
9. Once download is complete, wait five seconds or so to allow the ProMiniAir to boot up the first time to load the EEPROM, and then release the pins’ contact with the ProMiniAir ISP holes.

We do not provide a specialized ISP connector since establishing good electrical contact by merely tilting the pins works well and keeps the size of the ProMiniAir small and compact. Once the ProMiniAir receiver or transmitter firmware is installed in the Pro Mini and inserted into the ProMiniAir PCB, the ProMiniAir is ready for integration as described in Section 5!

## B Regulatory Notices

The following is a required FCC notice:
This equipment has been tested and found to comply with the limits for a Class B digital device, pursuant to part 15 of the FCC Rules. These limits are designed to provide reasonable protection against harmful interference in a residential installation. This equipment generates, uses, and can radiate radio frequency energy and, if not installed and used in accordance with the instructions, may cause harmful interference to radio communications. However, there is no guarantee that interference will not occur in a particular installation. If this equipment does cause harmful interference to radio or television reception, which can be determined by turning the equipment off and on, the user is encouraged to try to correct the interference by one or more of the following measures:
- Reorient or relocate the receiving antenna.
- Increase the separation between the equipment and receiver.

- Connect the equipment into an outlet on a circuit different from that to which the receiver is connected.
- Consult the dealer or an experienced radio/TV technician for help.

The following is a required IC notice:
Notice: This device complies with Industry Canada licence-exempt RSS standard(s). Operation is subject to the following two conditions: (1) this device may not cause interference, and (2) this device must accept any interference, including interference that may cause undesired operation of the device.
Avis: Cet appareil est conforme avec Industrie Canada RSS standard exempts de licence (s). Son fonctionnement est soumis aux deux conditions suivantes: (1) cet appareil ne peut
pas provoquer d’interferences et (2) cet appareil doit accepter toute interf ´ | erence, y compris ´
les interferences qui peuvent causer un mauvais fonctionnement du dispositif. ´

## References

[1] Anonymous. Communications Standards For Digital Command Control, All Scales. NMRA Standard S9.2, National Model Railroad Association, Inc., National Model Railroad Association, Inc., P.O. Box 1328, Soddy Daisy, TN 37384-1328, July 2004. https://www.nmra.org/sites/default/files/s-92-2004-07.pdf.
[2] Anonymous. Configuration Variables For Digital Command Control, All Scales. NMRA Standard S9.2.2, National Model Railroad Association, Inc., National Model Railroad Association, Inc., P.O. Box 1328, Soddy Daisy, TN 37384-1328, July 2012. https://www.nmra.org/sites/default/files/standards/sandrp/pdf/s-9.2.2_decoder_cvs_2012.07.pdf. (https://www.nmra.org/sites/default/files/standards/sandrp/pdf/s-9.2.2_decoder_cvs_2012.07.pdf)
[3] Anonymous. Fail-Safe Operating Characteristics For Digital Command Control, All Scales. NMRA Standard S9.2.4, National Model Railroad Association, Inc., National Model Railroad Association, Inc., P.O. Box 1328, Soddy Daisy, TN 37384-1328, July 2012. https://www.nmra.org/sites/default/files/s-9.2.4_2012_07.pdf.

## Abbreviations/Acronyms

DCC | Digital Command Control
ISM | Industrial, Scientific, and Medical
LCD | Liquid Crystal Display

NMRA National Model Railroad Association

OLED Organic Light-Emitting Diode

RF Radio Frequency

## Glossary

GFSK Frequency-Shift Keying (FSK) is an encoding technique in which digital information is encoded by a discrete frquency shift in the carrier frequency. In Gaussian Frequency-Shift Keying (GFSK), a temporal Gaussian filter smoothes the driving pulse that controls the frequency shift to reduce “sideband” output. The “DEVIATN” value specifies the frequency shift for the Texas Instruments CC1101 (and CC110L) transceiver chip used in the ProMiniAir.

I2C Inter-Integrated Circuit, sometimes abbreviated “IIC.” A synchronous, multi-master, multi-slave, packet switched, single-ended, serial computer bus invented in 1982 by Philips Semiconductor (now NXP Semiconductors).

ISM Band For the purposes of this document and for the US only, the 902–928 MHz RF band reserved for: “Operation of equipment or appliances designed to generate and use locally radio frequency energy for industrial, scientific, medical, domestic or similar purposes, excluding applications in the field of telecommunications.” Other ISM bands exist as well, both in the US and internationally.

OPS Mode “Operations Mode” or “Programming-On-the-Main” (PoM). The mode of a DCC throttle that can change the configuration variable (CV) for a DCC decoder at a specific address while the locomotive or device is operating.
