martan3d/AirMiniTransmitter/(list of files, drawings)

Other design files:
pcb/EasyEda/Current Designs/PCB_19-June-2025,-Mini-D1-Interface-PCB-w-CS-w-TI-Buck,-removed-resistor-dividers_2025-07-06.json
pcb/EasyEda/Current Designs/PCB_ProMini-Air-Thin,-09-Nov-2024,-slightly-wider_2024-12-29.json
pcb/EasyEda/Current Designs/PCB_ProMini-Air-Thin,-09-Nov-2024,-slightly-wider_2025-06-15.json
Turnout_Router/PCB/PCB_Pushbutton_Interface_w_OR_Rising_Edge_2026-03-08.json
Turnout_Router/PCB/PCB_Turnout_Router_Old_Latch_Bare_2026-03-08.json
