martan3d/AirMiniTransmitter/arduinoDcc/arduinoDcc1.3.brd

## EAGLE design arduinoDcc/arduinoDcc1.3.brd (2023-06-04)

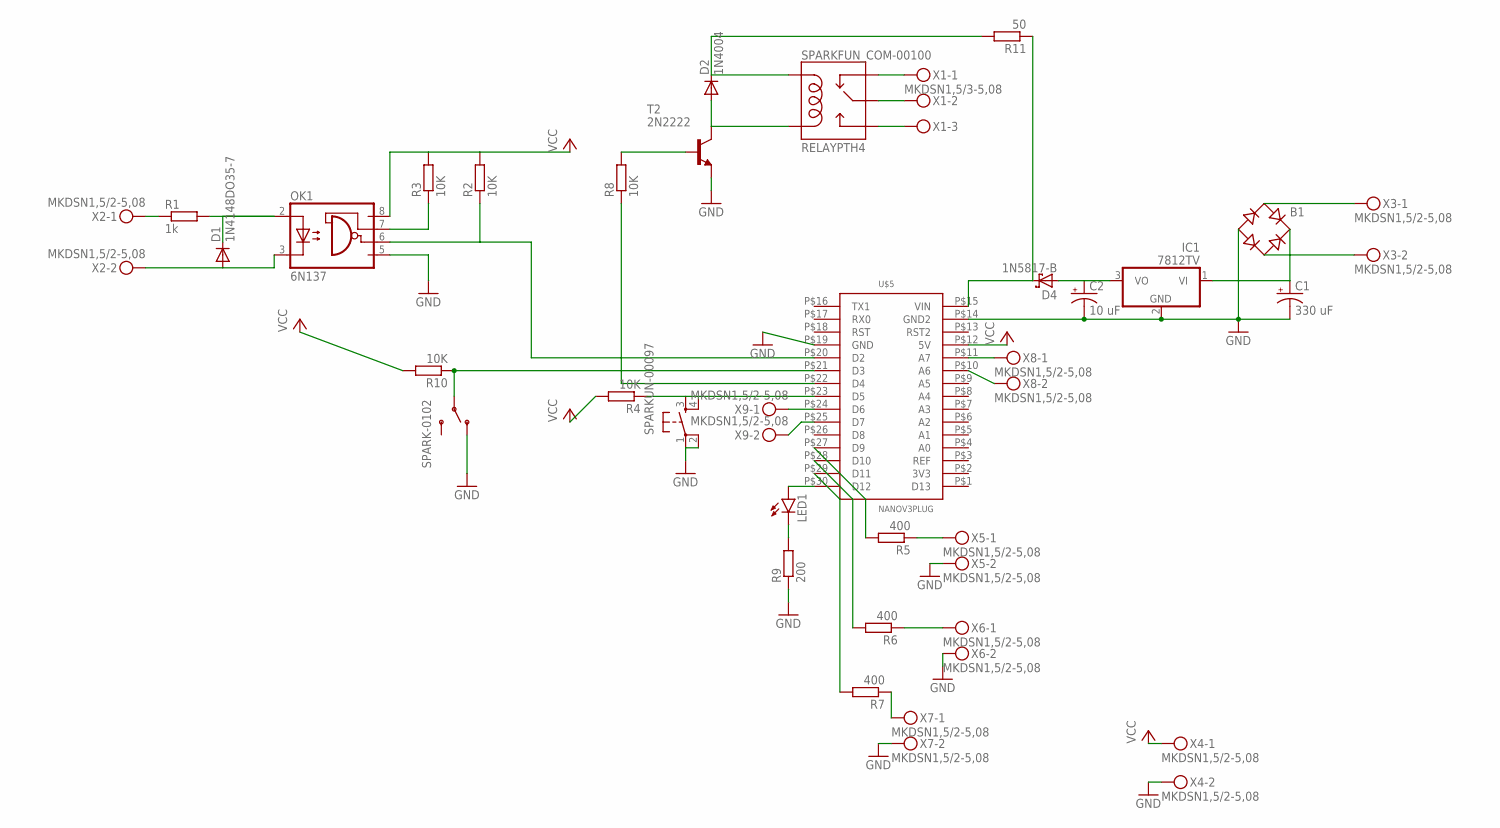
[picture p42: schematic arduinoDcc1.3.sch]

Parts:
B1: RB1A
C1: 330 uF; CPOL-RADIAL-100UF-25V
C2: 10 uF; CPOL-RADIAL-100UF-25V
D1: 1N4148DO35-7; DO35-7
D2: 1N4004; DO41-10
D4: 1N5817-B; DO41-7.6
IC1: 7812TV; TO220V
LED1: LED3MM
OK1: 6N137; DIL08
R1: 1k; 0207/10
R2, R3, R4, R8, R10: 10K; 0207/10
R5, R6, R7: 400; 0207/10
R9: 200; 0204/7
R11: 50; 0207/10
SPARK-0102: SWITCH-SPDTPTH; SWITCH-SPDT
SPARKFUN_COM-00100: RELAYPTH4; RELAY-JZC
SPARKUN-00097: TAC_SWITCHPTH; TACTILE-PTH
T2: 2N2222; TO18
U$5: NANOV3PLUG; HEADER15-2
X1: MKDSN1,5/3-5,08
X2, X3, X4, X5, X6, X7, X8, X9: MKDSN1,5/2-5,08

Connections:
GND: B1.-, C1.2 (-), C2.2 (-), IC1.2 (GND), OK1.5 (GND), R9.1, SPARK-0102.1 (O), SPARKUN-00097.1, SPARKUN-00097.2, T2.1 (E), U$5.P$14 (GND2), U$5.P$19 (GND), X4.2, X5.2, X6.2, X7.2
unnamed: R1.1, X2.1
unnamed: D1.C, OK1.2 (A), R1.2
unnamed: D1.A, OK1.3 (C), X2.2
unnamed: R10.1, SPARK-0102.2, U$5.P$21 (D3)
unnamed: D2.A, SPARKFUN_COM-00100.1 (COIL2), T2.3 (C)
unnamed: OK1.6 (VO), R2.1, U$5.P$20 (D2)
unnamed: OK1.7 (VE), R3.1
unnamed: B1.AC1, X3.1
unnamed: SPARKFUN_COM-00100.2 (NC), X1.1
unnamed: SPARKFUN_COM-00100.4 (MAIN), X1.2
unnamed: SPARKFUN_COM-00100.3 (NO), X1.3
unnamed: R8.1, U$5.P$22 (D4)
unnamed: R6.1, X6.1
unnamed: R7.2, U$5.P$29 (D11)
unnamed: R6.2, U$5.P$28 (D10)
unnamed: R5.2, U$5.P$27 (D9)
unnamed: R5.1, X5.1
unnamed: R4.1, SPARKUN-00097.3, SPARKUN-00097.4, U$5.P$23 (D5)
unnamed: U$5.P$24 (D6), X9.1
unnamed: U$5.P$25 (D7), X9.2
unnamed: U$5.P$11 (A7), X8.1
unnamed: U$5.P$10 (A6), X8.2
unnamed: B1.AC2, X3.2
unnamed: B1.+, C1.1 (+), IC1.1 (VI)
unnamed: LED1.K (C), R9.2
unnamed: LED1.A, U$5.P$30 (D12)
unnamed: R7.1, X7.1
unnamed: C2.1 (+), D4.A, IC1.3 (VO)
unnamed: R8.2, T2.2 (B)
unnamed: D2.C, R11.2, SPARKFUN_COM-00100.5 (COIL1)
unnamed: D4.C, R11.1, U$5.P$15 (VIN)
VCC: OK1.8 (VCC), R2.2, R3.2, R4.2, R10.2, U$5.P$12 (5V), X4.1

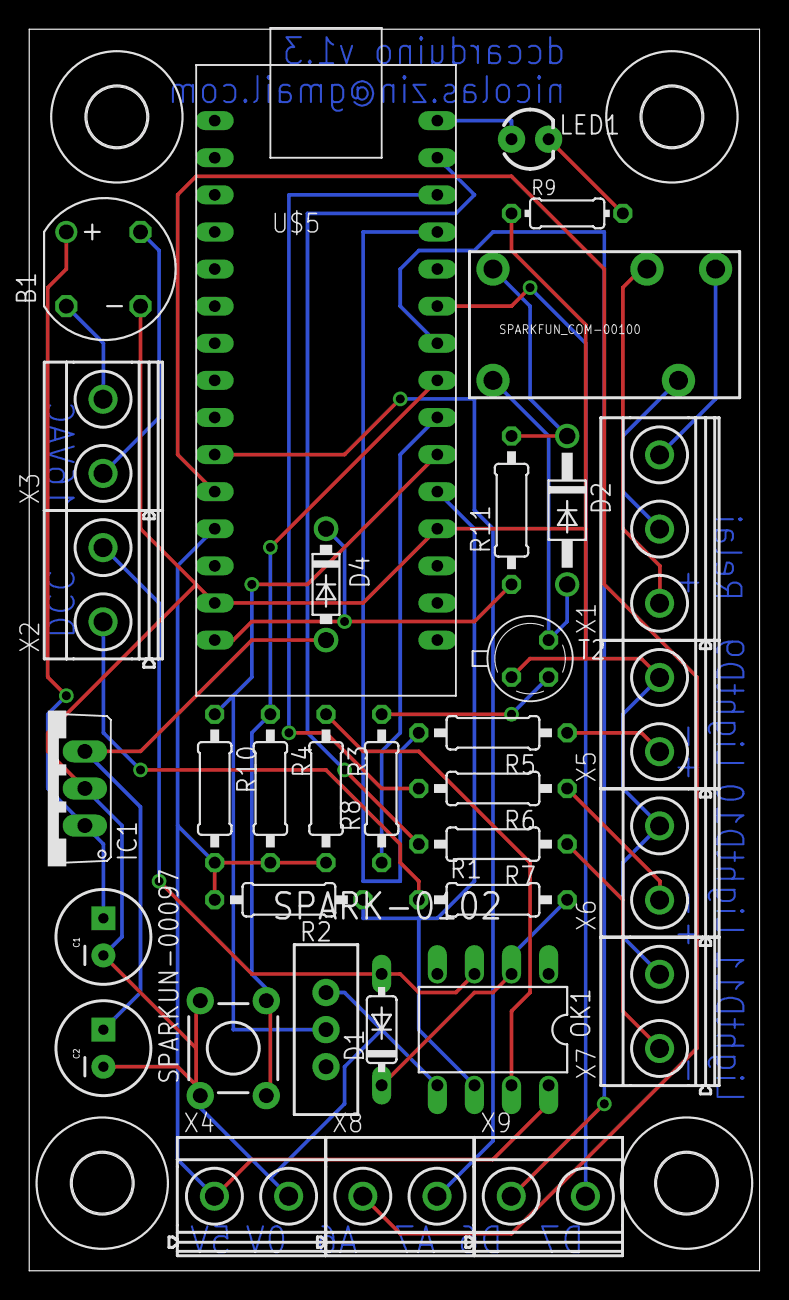
[picture p43: board arduinoDcc1.3.brd from above]

Board: 2 copper layers, 50.0 x 85.0 mm, 38 parts (0 on the bottom side), 33 nets.

Other parts of the board:
U$1, U$2, U$3, U$4: 4,1
