martan3d/AirMiniTransmitter/(commit log)

2019-10-19 Update config.h
    Made the transmitter compilation option active. Switching the defines will make the receiver option active.
2019-10-23 Added automatic channel switching in receiver mode.
    In receiver mode, added automatic switching to channel 0 if valid DCC is not detected on the current RF channel within 10 seconds after startup (approximately). This allows the user to be certain of the receiver's channel number if unknown by waiting 10 or so seconds before turning on the transmitter and setting to channel 0. The channel change is NOT permanent unless the user resets CV255 to a new channel number in OPS mode at the receiver's DCC address (default=9001).
    [AirMiniSketchTransmitter.ino]
2019-11-02 Update README.md
    Added comments about using a simple diode limiter circuit instead of an optoisolator.
2019-11-02 Addition of information for suppling power and DCC conversion to the transmitter.
2019-11-02 Added info on powering and DCC inputs
    Added information on how to provide power and DCC conversion that is compatible w/ the ProMini Air transmitter.
2019-11-03 Improved figures and wording.
    Improved the dcc converter schematic figure and some wording "improvements."
2019-11-10 Updated circuits and pictures
    Updated the combined DCC Converter/5V power supply circuit.
2019-11-15 Added information on DCC converter circuit
    Updated information on bridge rectifier/DC voltage supply/dcc converter circuit.
2019-11-18 Updated manual and corrected variable typing
    The manual has been updated to reflect recent Tam Valley Depot DRS1 improvements.
    Corrected the typing of a variable as pointed out during compilation.
    [AirMiniSketchTransmitter.ino]
2019-11-23 add pcb files
2019-11-23 completed board
2019-12-02 Added defines for various defaults. Increase in baudrate for receiver. User Manual updates.
    Added defines for various defaults.
    Increased the baud rate for receiver. It was too low.
    Updated the user manaul to discuss DCC filtering by the ProMiniAir receiver.
    [AirMiniSketchTransmitter.ino]
2019-12-13 Copyright notice and LED elimination
    Added copyright notice.
    Eliminated LED pin setting and access because of collision w/ use of LED_BUILTIN with SPI interface.
    Added back time delay for receiver to allow initial banner to display.
    Slight comment changes.
    [AirMiniSketchTransmitter.ino]
2019-12-13 Elimination of potentially harmful define & addition of 27MHz initializations
    Eliminated a define that might be harmful to the receiver chip.
    Added initialization for Anaren chips that operate at 27MHz rather than the usual 26MHz! This data came from the wireless-dcc project. Thanks!
    Added some commentary on settings. No functionality change.
    Slight comment clean-up.
2019-12-13 New define to activate Anaren board (27MHz) initialization data
    Added a define to possibly activate alternative settings for Anaren (and potentially other) boards that operate at 27MHz instead of the typical 26MHz!
2019-12-13 Updated information on DCC converter for the transmitter configuration
    Updated the information on the bipolar to 5V logic DCC converter for the transmitter option.
2019-12-14 Added a complete LiquidCrystal_I2C library based on an update from the Arduino IDE
2019-12-18 Improved use of defines & elimination of init hacking
    Improved the defines to use crystal frequency.
    Eliminated initalization hacking on MDMCFG variables.
    Decreased the SPI speed to slowest setting to ensure proper communications.
2020-01-05 Display improvements & better typing
    Improved the information on the I2C display, by alternating between the message ID and the ProMini Air's ID.
    Converted int64_t to uint64_t because we are dealing with unsigned quantities.
    Slight clean-up of comments.
2020-02-13 Added capability to turn off automatic IDLE packet insertion via CV244
2020-02-25 Updated description of Tx/Rx board differences
2020-02-27 Updated for CE-certified operation
    Updates to operate in Europe at 869.850MHz.
    Slight improvement in error checking and code formatting.
    [AirMiniSketchTransmitter.ino]
2020-03-14 Updated spi.c powers table with new PATABLE entries
    The powers PATABLES entries have been updated for European operation.
2020-03-17 Added comments about the modified I2C LCD library
2020-03-17 Massive revision: - Unification of the 26 and 27MHz transcevier setting as much as possible. Eliminated the notion of getting the data from "Original" or "wireless-dcc" sources of information. - Unif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
    [AirMiniSketchTransmitter.ino]
2020-03-18 Update of LiquidCrystal_I2C methods and EEPROM writing
    Updated the methods for the modified LiquidCrystal_I2C library to allow global declaration scope with a local init that sets address and sizing parameters.
    Added timing delays to EEPROM writes to ensure they are "in place" before use.
    The file config.h now has defines to prevent multiple inclusion.
    [AirMiniSketchTransmitter.ino]
2020-03-19 Documentation update
    Documentation update providing I2C address information.
2020-03-20 Lengthened the delays for EEPROM writes
    Reliability of writing these defaults is a concern. Sometimes initialization to the transceiver does not work. Re-flashing seems to work.
    [AirMiniSketchTransmitter.ino]
2020-03-21 Inserted time delays to ensure EEPROM writing is successful
    Inserted an initial 1s delay to help ensure subsequent EEPROM writes are successful. In function setup, moved all variable initialization before final pin and timer setup, and interrupt start.
2020-04-19 Reboot capability and "improved" reliability.
    Added ability to fully reset the state.
    Shortened the display update rate.
    Added eeprom waits after eeprom updates.
    Added interrupt turn-off and turn-off during eeprom updates during CV changes.
    [AirMiniSketchTransmitter.ino]
2020-04-19 Eliminated all of recently-added cli/sei calls during CV changing!
    Eliminated all of recently-added cli/sei calls during CV changing! It does not appear to be necessary, and may cause problems if they remain.
    [AirMiniSketchTransmitter.ino]
2020-04-19 Added turn-off of interrupts just before full reset
    [AirMiniSketchTransmitter.ino]
2020-06-25 Update AirMiniSketchTransmitter.ino
    Spelling correction in a comment. No functionality change.
    [AirMiniSketchTransmitter.ino]
2020-07-29 Updated 2.4GHz data
    Based on documentation review, changed 2.4GHz setting to comply with regulatory requirements.
2020-07-30 Added 434MHz channels and clean-up
    Added channels 0-7 to 434MHz ISM band. Works.
    Clean-up of character, channels, and powers arrays to put then into program memory (as const) rather than ram.
    Added error checking on crystal frequency setting.
    "Corrected" logical operators on #if's.
    Updated 434MHz init[TR]xData for new channels with a base frequency of 433.2MHz and a 200kHz channel spacing.
    [AirMiniSketchTransmitter.ino]
2020-08-05 Added small time-delay after initialization of the SPI
2020-08-05 FIFOTHR upper word correction. SPI speed change
    Removed the upper word in FIFOTHR, since it's reserved and supposed to be zero.
    Change the SPI speed from slowest to second slowest to help ensure proper data sampling.
    Added SPSR and SPDR in initializeSPI to clear out any possible junk.
2020-08-12 Added setting of SPCR and MISO waits
    Added the ability to reset the value of SPCR from config.h.
    After selecting the modem, added a wait until MISO goes LOW that indicates the modem is ready. Most CC1101 libraries do this for SPI communication.
2020-08-12 Faster data transfer and critical-section interrrupt turnoff
    Using memcpy to speed the transfer of values among the DCC message packets.
    Added critial-section interrupt turn-off. This can be turned off by #define DONTUSEINTERRUPTS in config.h.
2020-08-12 Addition of configuration options
    The user must uncomment the appropriate "easy" settings.
    Added some expert setting dealing with repeaters, SPI configuration, and interrrupt turn-off. Use with care!
2020-08-18 Changed port read/writes
    Changed to a less error-prone PORTB and PINB write/read method that automatically determines and uses the correct bit mask for MISO and CSN(SS).
    [AirMiniSketchTransmitter.ino]
2020-08-19 Use of #define for some 2.4GHz settings
    The "ALTERNTIVE2P4" setting currently do NOT work! For future investigation.
2020-08-19 Abstraction of begin/endSPI()
    Made beginning and ending of SPI actions to functions.
    Added pulling SCK low in endSPI().
2020-08-20 Elimination of unused variables. Improved names.
    Eliminated currentIndex. Not really being used well. Changed function names to bring in line with other software packages.
2020-08-23 Made the spi wait mask name standard
2020-08-25 Insertion of config.h for Europens to pick up.
    These changes will be reverted once Europeans pick up the mods.
2020-08-27 Simplified coding for information messages
    Simplified the coding for an informative messages.
    Ensured the filterModem values from CV246 is set to one if non-zero is entered.
2020-09-18 Added automatic I2C address scanning
    This change eliminates the need for setting the I2C address in the config.h file.
2020-09-18 Removed use of LCDADDRESSDEFAULT
    Address selection of the I2C LCD is now "automatic". If one valid I2C address is found by Wire, then it is used. Otherwise (i.e., 0 or more than 1 I2C devices are found), displaying to the LCD is disabled.
2020-09-22 Moved location of Wire.begin to reduce boot-up time.
2021-05-04 Code simplification and removal of spurious carriage retursn
    spi.c: simplified (1 << SPIF) to a single variable.
    uart.c: removed spurious carriage returns
2021-05-10 Maintainability and display improvements
    spi.c: Improved maintainability by using a MACRO instead of a variable assignment. No functionality change.
    AirMiniSketchTransmitter.ino: Added display of DCC command on the LCD.
2021-05-21 Fix of valid packet detection
    Added a size check for a valid DCC message in dcc.c. Otherwise, the auto-detection will not work.
    AirMiniSketchTransmitter.ino: added a clear of TASK1 in the initialization (just to be sure).
    [AirMiniSketchTransmitter.ino]
2021-06-03 Changes to servo.c and servotimer.h
    No functionality change, just removal of spurious ^M at the end of the lines.
2021-06-03 Update ProMini_Air_nrf24_rx_dcc.ino
    Change from using a flag to direct timer_val updating.
2021-06-03 Update DCCLibrary.cpp
    Changed states to members of an enum.
    Replaced pinMode with DDRD.
    Replaced digitalWrite to PORTD commands.
    Eliminated the flag variable and directly set timer_val.
2021-06-03 Update ProMini_Air_nrf24_tx_rx_dcc.ino
    Clean-up of timer_val initial value.
    Use of trigraph to set timer_val instead of if/else.
    No important functionality change is expected.
2021-06-06 Type declaration changes
    uint8_t -> unsigned char
    uint16_t -> unsigned short
    uint64_t -> unsigned long
    In spi.c added setup of Pins 8 and 9, even though they are not used, but set up
    with the DDRB setting.
    No expeccted functionality changes.
    [AirMiniSketchTransmitter.ino]
2021-06-06 Movement of dcc.c and dcc.h to separate library
    The move of dcc.c and dcc.h eliminates interrupts conflicts with AirMiniSketchTransmitter_Nmra.ino, which internally uses the same interrupts as dcc.c.
2021-06-06 Update AirMiniSketchTransmitter_Nmra.ino
    Type name changes that are not expected to affect functionality.
    Added debugging code and code to try to improve misbehavior of setting EEPROM variables, some of which do not currently work consistently.
2021-06-07 Update AirMiniSketchTransmitter_Nmra.ino
    Simplified the output logic selection in the timer2 function. Tested and works. Also turned off the DEBUG option.
2021-06-07 Simplification of TIMER2 ISR assignments and variables
    Eliminated unneeded variable assignment and declarations. Tested.
    No expected functionality change.
2021-06-08 Update AirMiniSketchTransmitter.ino
    Unimportant changes:
    - changed type unsigned char back to uint8_t
    - changed unsigned long back to uint64_t
    - changed unsigned short back to uint16_t
    Important changes
    - Changed the content of type Message to bring into conformance with
    the NmraDCC library's DCC_MSG type.
    - Changed dccptr to type Message and resulting impact on accessing
    dccptr's contents.
    - Added checkSetDefault function for debugging.
    - Slightly changed function checkSetDefaultEE to
    - Eliminate null pointer detection.
    - Added debugging output when activated.
    - Added EEPROM write failure detection and a limited number of retries to fix
    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
    [AirMiniSketchTransmitter.ino]
2021-06-08 Update AirMiniSketchTransmitter_Nmra.ino
    Important changes:
    - Changed all millis() calls to micros() for improved timing precision
    - Eliminated numerous micros() timing calls and used time "then"
    instead. This coordinates event timing. Perhaps little impact.
    - Changed the units of some timing-related #define's to use
    microseconds instead of milliseconds.
    - Correction of error in how EEFirst was accessed to detect first-time
    boot up for loading EEPROM.
    - changed type unsigned char back to type uint8_t
    - changed type unsigned long back to type uint64_t
    - changed type unsigned short back to type uint16_t
    - Cleaned up initialiizer for msg a bit.
    - Change the time for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
    [AirMiniSketchTransmitter_Nmra.ino]
2021-06-09 Automatic idle message insertion corrections
    Corrections to ensure that enough idle messages are sent in transmitter
    mode to keep Airwire receivers working properly. These changes involved changing the insertion logic and some global variable passing.
    Also changed the LCD "CV change message" to two lines to ensure
    large CV values (with 3 digits) are completely displayed.
    [AirMiniSketchTransmitter.ino, AirMiniSketchTransmitter_Nmra.ino, ProMini_Air_nrf24_tx_rx_dcc.ino]
2021-06-20 Update ProMini_Air_nrf24_tx_rx_dcc.ino
    Changed the input pin in transmitter mode to Pin D3, along with its associated timer interrupt number.
2021-06-24 Filtering improvements and code clean-up
    Prevent filtering of the DCC packet for change CV setting, which requires 2 identical messages. Made local variables global to prevent local allocation/deallocation.
    [AirMiniSketchTransmitter.ino, AirMiniSketchTransmitter_Nmra.ino]
2021-10-21 DCC display output improvements
    Improved information on displayed DCC output; i.e., whether it was internally replaced.
    [ProMini_Air_nrf24_tx_rx_dcc.ino]
2021-10-21 Update ProMini_Air_nrf24_tx_rx_dcc.ino
    Added preprocessor directives to replace dccptr with the inserted idle message or not (for display). Cleaned up TCNT2 assignment including latency effects.
    [ProMini_Air_nrf24_tx_rx_dcc.ino]
2021-11-16 Update spi.c
    Added infrastructure for possible Tam Valley Depot compatibility. No used yet. Clean-up of defines for clarity. No functionality changes.
2021-11-16 Update to latest version of SmartRC-Driver-Lib
    Don't currently use this library except to provide possible inspiration.
2022-05-12 Libraries update and addition of board output enable
    Supporting libraries have been updated.
    An output enable has been added to the software and board hardware.
    The default crystal frequency is now 26MHz since supply chain problems have
    created unavailability of 27MHz chips.
    [AirMiniSketchTransmitter.ino, AirMiniSketchTransmitter_Nmra.ino, ProMini_Air_nrf24_tx_rx_dcc.ino]
2022-05-19 Update README.md
    Corrected the default addresses and changed the discussion about finding the address of the I2C display.
2022-05-20 Update AirMiniSketchTransmitter.ino
    Corrected software version.
    [AirMiniSketchTransmitter.ino]
2022-07-15 Corrected serious error in spi.c
    The initTxData was improperly dimensioned!!!
    Added a check to redefine SPCR, SPSR, and SPDR for the case of an Atmega328pb instead of an Atmega328p.
2022-07-26 Clean-up. No functionality change
    spi.c:
    - Removed spurious text.
    - Removed Atmega328pb defines.
    spi.h:
    - Moved include of config.h inside SPI_H_ context.
    - Added possible future defines for Atmega328pb. Currently commented out.
2022-07-30 Update AirMiniSketchTransmitter.ino
    Reduced the memory footprint by decreasing the size of the ring buffer.
2022-07-30 Update spi.c
    Elimination of unnecessary variable when clearing the SPI buffers.
    Addition of beginSPI() ... endSPI() for several strobeSPI(...) calls. May improve performance stability.
2022-08-16 Added capability to select different DCC output types
    If CV253 !=0, then locked anti-phase (DCC on DCC+ and HIGH on DCC-). If CV253=0, then DCC on DCC+ and inverted DCC on DCC-.
    [AirMiniSketchTransmitter.ino, AirMiniSketchTransmitter_Nmra.ino]
2022-09-23 Removed awk scripts and added PCBs. Updated .gitignore.
    Removed highly-technical awk scripts. Added PCB files.
2022-09-23 Clean-up.
    Cleaned up pcb directories. Move shell scripts to bin directory.
    [45-PCB_ProMini Air, 22 Sep 2022, smaller LDOs, on-board MCU, holes, Y157-2822753A.json, 6-PCB_DCC_Converter_02_Aug_2022_w_Opto_Isolator, updated 1K, Test +5V LDO.json]
2022-10-19 Modifications related to increasing preamble bits size
    Modifications related to improving Airwire compatibility:
    - Increased preamble bit size to 30
    - Added capability to change preamble bits size via CV242
    - Added capability to change the long pulse time via CV241
    - Made power level resetting permanent to allow for external amplification
    - Code formatting clean-up. No functionality change
    - Added options in the config.h file to change the preamble bit size and long
    pulse length at compilation time
    [AirMiniSketchTransmitter.ino, AirMiniSketchTransmitter_Nmra.ino]
2022-10-25 "Improved" Airwire compatibility
    Added "cut-outs" of varying length in an attempt to improve Airwire compatibility.
2022-10-28 Update AirMiniSketchTransmitter_Nmra.ino
    - Changed the way preamble_bits is assigned to eliminate conditional test in an ISR
    - Cleaned up setting preamble_count w/ preprocessor directives
    - Added CUTOUT state for the location where the next message is obtained and the
    cutout parameters established for the second half of the bit.
    - Corrected error in location of USE_CUTOUT preprocessing directive
    - Cleaned up variable naming, including state -> next_state and previous_state -> current_state
    to improve code understanding
    [AirMiniSketchTransmitter_Nmra.ino]
2022-10-31 Documentation update on interrupts
2022-11-02 Moved servo code to prevent unneeded compilation. Updated .gitignore
2022-11-02 Waveform consistency improvements
    - Added a synchronization technique to even out ISR timing
    jitter before setting the waveform. Uses the ADVANCE parameter.
    - Changed to use TIMER1 for improved ISR time resolution
    - Changed TIMER_LONG_CUTOUT2 for 109usec pulse length
    - Changed TIMER_LONG_CUTOUT1 for 106usec pulse length
    - Improved typing using static and volatile where appropriate
    - Went back to PORTD rather than the portOutputRegister and digitalPinToBitMask
    formalism
    - By default, do NOT turn off interrupts in message assignment sections
    Resettable in config.h (at your own risk)
    [AirMiniSketchTransmitter_Nmra.ino]
2022-11-02 Corrected ifdefs for cutout insertion (not for receiver)
    [AirMiniSketchTransmitter_Nmra.ino]
2022-11-04 Update AirMiniSketchTransmitter_Nmra.ino
    Made the ISR advance a variable that can be reset via CV 236.
    [AirMiniSketchTransmitter_Nmra.ino]
2023-02-21 Update spi.c
    Removed redundant beginSPI/endSPI around strobeSPI calls.
2023-02-21 Update AirMiniSketchTransmitter_Nmra.ino
    - Changed how Idle is inserted into ISR routine, giving the ISR as long as possible to obtain a new, valid DCC message. Replaced message copying with pointers.
    - Extensive reformatting based on cpplint analysis.
    - Eliminated intermediate variables
    - Added Service Mode detection to prevent filtering of these messages
    - Changed logic for idle message insertion. This feature does not seem to be necessary since long cutouts have been added to the waveform ISR.
    - Eliminated several sleep/wakeup variables that are no longer used to turn on/off output filtering.
    [AirMiniSketchTransmitter_Nmra.ino]
2023-02-27 Update AirMiniSketchTransmitter_Nmra.ino
    Removed cut-out waveform insertion for the transmitter. Retained the long preamble for the transmitter that the Airwire receivers seem to demand.
    Corrected preamble count assignment.
    [AirMiniSketchTransmitter_Nmra.ino]
2023-02-27 Update of EasyEDA ProMiniAir PXB
    [45-PCB_ProMini Air, 22 Sep 2022, smaller LDOs, on-board MCU, holes, Y157-2822753A.json, 48-PCB_ProMini Air, 06 Nov 2022, same as 22 Sep 2022 & 20 Oct 2022, but changed labeling.json]
2023-03-26 Important update
    - Removed automatic IDLE message insertion and replaced it with preamble bit insertion while waiting for a valid message. This eliminates the possibility that spurious IDLE messages foul up message sequencing; e.g., Service Mode messages.
    - Activated pull-up on the input pin. This does not affect active input drivers, but it does allow for "active low" and "high-impedance high" inputs.
    [AirMiniSketchTransmitter_Nmra.ino]
2023-03-28 Update AirMiniSketchTransmitter.ino
    Turned off auto idle insertion by default.
    Ensure the output dcc packet has 30 preamble bits for Airwire compatibiity.
2023-03-28 Preamble lengthening for Airwire compatibility
    - Used preamble_bits from main executable.
    - Added EXTENDPREAMBLE state to ensure the number of preamble bits
    matches that of the messages PreambleBits.
    - Removed #defines
    - Adding extra preamble bits while waiting for a valid message and eliminated
    IDLE message insertion.
2023-04-09 Added new LCD display (128x32)
    - Added the preprocessor option to use a 128x32 OLED LCD.
    - Remove double pass requirement to receive an OPS mode CV value change.
    - Removed variables related to insertion of IDLE messages, which is no longer
    used.
    - Moved initialization of the LCD to setup().
    [AirMiniSketchTransmitter_Nmra.ino]
2023-06-04 Updated EasyEDA files
    [48-PCB_ProMini Air, 06 Nov 2022, same as 22 Sep 2022 & 20 Oct 2022, but changed labeling.json, 6-PCB_DCC_Converter_02_Aug_2022_w_Opto_Isolator, updated 1K, Test +5V LDO.json]
2023-06-04 Added Accessory Decoder Projects
    [arduinoDcc1.3.brd, arduinoDcc1.3.sch]
2023-06-20 Made changing deviatn via CV243 available. Cleaned up current PCB designs.
2023-07-11 Update of EasyEda PCBs
2023-11-04 Technical changes to allow setting a specific frequency and deviation
    Added CV233, CV234, and CV235 to set CC1101 FREQ0, FREQ1, and FREQ2 and use CV243 for DEVIATN. These changes are NOT persistent after turn-off.
    Changed OLED/LCD printing to a macro to reduce source code bloat. Slight changes in variable names to improve code clarity.
2023-11-11 Clean-up of preprocessor for OLED/LED print line.
    No functionality change.
2024-01-27 Updates of the RF24 and Servo libraries
2024-08-26 Update of pcbs
2024-09-18 Added ability to change filter on and DC level defaults from the config.h file.
2024-10-12 Important update: - Changed default to filtering is ON: - Filtering ON => DC when no valid DCC - Filtering OFF => Preamble bits when no valid DCC - Technical changes: - Use NmraDcc library to change 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
2024-10-14 A technical improvement: Simplified filtering output turn on.
2024-10-26 Removed unused #defines. Change in filtering defaut #define
2024-11-29 - Removal of unused #defines. No functionality change. - Insert idle message is after tooLong and filtering is off. - Changed the assignment of preamble_count using a trigram - Increased MAX_NUM_CUTO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
2024-12-07 Updated Users Manual to reflect new defaults and repeat packet insertion.
2024-12-09 Corrected error on when to insert and IDLE message
    [AirMiniSketchTransmitter_Nmra.ino]
2024-12-11 Correct idle insertion logic to prevent its interference with channel scanning.
    Changed the default for filtering to OFF.
    [AirMiniSketchTransmitter_Nmra.ino]
2024-12-11 Modified the defaults for filtering and repeating DCC packets.
2024-12-15 Corrected & to && in if statement
    [AirMiniSketchTransmitter_Nmra.ino]
2024-12-30 Update of EasyEda file for PMA Rx/Tx PCB
    [PCB_ProMini-Air-Thin,-09-Nov-2024,-slightly-wider_2024-12-29.json]
2026-02-13 Updated PCB designs
    [PCB_19-June-2025,-Mini-D1-Interface-PCB-w-CS-w-TI-Buck,-removed-resistor-dividers_2025-07-06.json, PCB_ProMini-Air-Thin,-09-Nov-2024,-slightly-wider_2025-06-15.json]
2026-02-13 Update Turnout_Router.ino
    Changed address validation of encoder to use the _GS output
